mpa216/Deep-Learning-Accelerator-DLA-Engine-From-CNN-to-GenAI-SNN/3V3lib/gf180mcu_ocd_io-main/docs/index.rst

******************************************************
gf180mcu_ocd_io 5V pad / 3.3V core Inline non-CUP GPIO
******************************************************

.. centered::
   **Open Circuit Design 0.18µm **
.. centered::
   **5V pad / 3.3V core Wide-Range Inline non-CUP GPIO Library**
.. centered::
   **Datasheet**

.. toctree::
    :glob:

    datasheet
    features
    naming
    functional
    specs
