mpa216/Deep-Learning-Accelerator-DLA-Engine-From-CNN-to-GenAI-SNN/Papers/APIC_Paper/Revised_Reference/apsipa_version.tex

\documentclass[conference,a4paper]{APSIPA2026}
\usepackage{cite}
\usepackage{amsmath,amssymb,amsfonts}
\usepackage{graphicx}
\usepackage{textcomp}
\usepackage{xcolor}
\definecolor{figblue}{RGB}{37,84,160}
\definecolor{figred}{RGB}{198,58,45}
\usepackage{booktabs}
\usepackage{array}
\usepackage{multirow}
\usepackage{tikz}
\usetikzlibrary{shapes.geometric,arrows.meta,positioning,calc}
\usepackage{url}
\usepackage{geometry}
\geometry{a4paper, top=19mm, bottom=43mm, right=13mm, left=13mm}
\usepackage{fancyhdr}
\renewcommand{\headrulewidth}{0pt}
\renewcommand{\footrulewidth}{0pt}
\fancypagestyle{firststyle}{%
  \fancyhf{}%
  \fancyhead[C]{2026 Asia Pacific Signal and Information Processing Association Annual Summit and Conference (APSIPA ASC)}%
}
\usepackage[hidelinks]{hyperref}
\graphicspath{{figs/}}

\begin{document}

\title{An 8-bit Deep Learning Accelerator for\\GAN Image Generation on GF180MCU}

\author{
\IEEEauthorblockN{William Anthony, I~Made~Medika~Surya~W.M., John~Ruben~Saragi, Mahardhika~Putra~Adipratama,\\
Fairuz~Aquilla~Rahagi, Trio~Adiono, and Infall~Syafalni}
\IEEEauthorblockA{Bandung Institute of Technology, Bandung, Indonesia \\
E-mail: \{13223048, 13222021, 13222049, 13222081, 13222107\}@mahasiswa.itb.ac.id, \\
tadiono@itb.ac.id, infall@ieee.org}
}

\maketitle
\thispagestyle{firststyle}
\pagestyle{empty}

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

\begin{IEEEkeywords}
Deep learning accelerator, GF180MCU, SRAM macro, INT8 quantization, GAN, ASIC, LibreLane, open-source EDA.
\end{IEEEkeywords}

\section{Introduction}
Generative Adversarial Networks can be used as a compact workload for testing neural inference on custom hardware. In this work, the generator is a small MNIST multi-layer perceptron that converts a 64-dimensional latent vector into a $28\times28$ image. The arithmetic is mostly dense matrix multiplication, so the workload can be mapped onto a small array of multiply--accumulate units.

An earlier version of the design used sequential behavioral loops and register memory arrays in Verilog. That version was convenient for checking the algorithm, but not suitable for ASIC implementation: buffers inferred as standard-cell registers make the design too large and difficult to route. The design was therefore restructured into a structural accelerator with a processing-element (PE) array, local SRAM-backed buffers, and a small controller, and carried through a two-stage physical flow: the core is hardened as a macro, and the macro is integrated onto a padring for a shared-shuttle slot.

The main contributions are: (1)~an open INT8 GAN-generator accelerator on GF180MCU whose buffers use physical SRAM macros; (2)~a verification stack reaching from unit vectors to a bit-exact full-image render on the routed post-layout netlist; (3)~a single-supply 3.3~V implementation of the full flow, including third-party library fixes and a reproducible antenna-closure method; and (4)~chip-level integration behind a 4-wire serial interface with a clean sign-off.

\section{Related Work}
Most neural network accelerators are built around arrays of multiply-and-accumulate units. A well-known large-scale example is the systolic Tensor Processing Unit \cite{tpu}, and a broad overview of deep learning accelerators for different platforms is given in \cite{survey}. To run a floating-point network on this kind of integer array, the weights and activations are usually quantized with a per-tensor scale, as described by Jacob et al. \cite{jacob}.

The closest work to ours is Wang et al. \cite{wang}, which presents a small PE-array accelerator for an underwater recognition network in a 40~nm process. Our design is different because it targets the open GF180MCU 180~nm process and uses a full open-source flow from RTL to a tapeout-ready chip GDS. The workload is a pretrained MLP GAN \cite{goodfellow, ganpretrained}, and the RTL is based on the open DLA Engine project \cite{dlaengine}.

\section{GAN Architecture}\label{sec:overview}

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

The GAN generator architecture, illustrated in Fig.~\ref{fig:gan}, uses a multi-layer perceptron (MLP) model that receives a latent vector of size 64 as the initial input. This input is then projected through two hidden layers, each containing 256 neurons, to form a richer feature representation. Each hidden layer is followed by a ReLU activation function, allowing the model to learn non-linear patterns from the data.

After that, the learned representation is passed to an output layer with 784 neurons, which corresponds to a $28\times28$ pixel image. In the final stage, a tanh activation function is used to limit the output values to a range between $-1$ and $1$, so that the output of the generator can be represented as a grayscale image. Through this process, the generator transforms a random vector into a synthetic image that resembles real data.

Table~\ref{tab:net} lists the three dense layers and shows how many tiles each layer needs on the $4\times4$ array. Because the array produces four output neurons per tile, the layer with 784 outputs needs the most tiles.

\begin{table}[h]
\caption{Generator layers and their mapping to the $4\times4$ array.}
\label{tab:net}
\centering
\renewcommand{\arraystretch}{1.08}
\begin{tabular}{@{}lcccc@{}}
\toprule
Layer & Output $\times$ Input & Activation & Tiles & MAC ops \\
\midrule
L0 & $256\times64$  & ReLU & 64  & 16{,}384  \\
L2 & $256\times256$ & ReLU & 64  & 65{,}536  \\
L4 & $784\times256$ & Tanh & 196 & 200{,}704 \\
\midrule
Total & & & 324 & 282{,}624 \\
\bottomrule
\end{tabular}
\end{table}

\section{Hardware Architecture}\label{sec:hw}

The DLA computes a tiled matrix multiplication $C=A\times B$. The array size is $N=4$, and the native accumulation depth is $K=256$, so one transaction accumulates a full 256-term dot product---the inner dimension of the widest generator layers. $K$ is a temporal depth: it sets how many cycles the same 16 PEs accumulate, not the array size. An earlier RTL revision defaulted to $K=4$ and relied on a harness override; since the physical flow synthesizes the bare RTL defaults, the hardened default was widened to $K=256$---a parameter-only change, as the operand SRAMs were already 256 deep. During one transaction, the controller clears the PE accumulators, enables the array for $K$ cycles, and then stores the result block to the C buffer through a writeback path.

\begin{figure}[h]
\centering

\caption{DLA engine top level.}
\label{fig:top}
\end{figure}

At the top level, shown in Fig.~\ref{fig:top}, the A buffer provides one row vector to the PE array, and the B buffer provides one column vector. The control unit generates the read index, clear signal, enable signal, done signal, and busy signal. The output bus carries the accumulated C values.

\subsection{Processing Element}

Each processing element (Fig.~\ref{fig:pe}) receives two signed 8-bit inputs. It multiplies them, sign-extends the 16-bit product to 24 bits, and adds it to a local accumulator. The accumulator is cleared at the start of each matrix multiplication. The output of each PE is one dot product.

\begin{figure}[h]
\centering

\caption{Processing element datapath.}
\label{fig:pe}
\end{figure}

The main computation in one PE follows
\begin{equation}
acc_{out}[n] = acc_{out}[n-1] + a_{in}[n]\,b_{in}[n].
\end{equation}
After $K$ cycles, the accumulator stores one output value of the matrix multiplication tile. A 24-bit accumulator is used so that the sum of 8-bit products has enough range for the selected layer sizes.

\subsection{PE Array}
The PE array (Fig.~\ref{fig:pearray}) instantiates 16 PEs in a $4\times4$ grid. Each row receives one activation lane, and each column receives one weight lane; the operands are broadcast along the rows and columns, and each PE accumulates its result locally (an output-stationary organization), so all 16 PEs operate in parallel and the array produces one $4\times4$ output tile after the accumulation loop finishes.

The $a\_bus$ contains four 8-bit activation values, while the $b\_bus$ contains four 8-bit weight values. The output $c\_bus$ is flattened from 16 accumulator outputs, each with 24 bits.

\begin{figure}[h]
\centering

\caption{Processing element array.}
\label{fig:pearray}
\end{figure}

\subsection{Controller FSM}
The controller uses four states (Fig.~\ref{fig:fsm}). In IDLE, it waits for START. In CLEAR, it clears all PE accumulators for one cycle. In COMPUTE, it asserts the PE-array enable and increments the A and B buffer addresses until all $K$ terms have been processed. In DONE, it raises DONE and waits for START to return low before going back to IDLE. A separate writeback sequencer then serializes the 16 accumulator values into the C buffer and raises a writeback-done flag.

\begin{figure}[h]
\centering
\begin{tikzpicture}[
  font=\scriptsize,>={Stealth[length=2mm]},
  st/.style={draw,circle,minimum size=10mm,fill=green!8}
]
\node[st] (idle) {IDLE};
\node[st,right=11mm of idle] (clear) {CLEAR};
\node[st,right=11mm of clear] (comp) {COMP};
\node[st,right=15mm of comp] (done) {DONE};
\draw[->] (idle) -- node[above]{start} (clear);
\draw[->] (clear) -- (comp);
\path (comp) edge[->,loop above] node{$k<K-1$} (comp);
\draw[->] (comp) -- node[above]{$k=K-1$} (done);
\draw[->] (done) to[bend left=45] node[below]{!start} (idle);
\end{tikzpicture}
\caption{Controller state machine.}
\label{fig:fsm}
\end{figure}

\subsection{SRAM Buffers}
The input and output buffers are implemented with physical $256\times8$ single-port SRAM macros. The A buffer uses four macros, one for each row lane. The B buffer also uses four macros, one for each column lane. The C buffer stores 24-bit accumulator outputs by using three 8-bit SRAM macros as byte planes of one 24-bit word. In total, the design uses eleven SRAM macros, 2{,}816 bytes of storage; the roughly 280~KB of INT8 generator weights are streamed through these tiles from outside rather than stored on chip.

The SRAM wrapper has a behavioral memory model for simulation and a blackbox branch for synthesis; the power pins are not tied to logic constants in RTL but connected by the physical power delivery network during place and route. The SRAM read has one cycle of latency, so the top level delays the PE enable and completion flags by one cycle to keep data and control aligned, which prevents the PE array from accumulating invalid data after a read request.

\section{Chip-Level Integration}\label{sec:chip}

The hardened accelerator exposes 53 signal bits (a 10-bit write address alone, now that $K=256$), but the target shuttle slot provides only 20 general-purpose digital pads next to its 60 analog, 8 supply, clock, and reset pads. Instead of a pin-per-signal mapping, the chip core wraps the accelerator behind a small synchronous 4-wire serial bridge (SCLK, MOSI, CS\_N, MISO). The bridge treats SCLK as a data input: all three inputs are double-flop synchronized into the core clock domain and SCLK is edge-detected, which deliberately avoids a second clock domain. A frame is shifted MSB-first while CS\_N is low as a 2-bit command plus a 10-bit address (write frames append 8 data bits): WRITE\_A and WRITE\_B load the operand buffers, START launches one tile, and READ\_C returns one 24-bit two's-complement result on MISO. Raising CS\_N at any point aborts the frame safely. Three status flags (busy, done, writeback-done) bypass the serial link and drive pads directly, giving oscilloscope-visible liveness during board bring-up. In total the chip uses 9 of the slot's 91 pads (the serial link, the status flags, clock, and reset); the remaining bidir pads are tied off with pull-downs.

The padring is the wafer.space GF180MCU project template \cite{padring} for a $2935\times2935~\mu$m workshop slot. One consequence of the template is that the pad supply and the core supply are shorted into a single rail on every pad, so the chip is single-supply by construction. The adopted operating point is therefore 3.3~V for the whole die: the logic and SRAM are 3.3~V parts, and the foundry I/O cells are officially characterized for 3.3~V operation, so every cell on the die operates in a foundry-characterized corner and the I/O levels are directly compatible with a 3.3~V microcontroller host. Fig.~\ref{fig:chipgds} shows the final chip layout.

\begin{figure}[t]
\centering

\caption{Final chip layout ($2935\times2935~\mu$m slot): the DLA macro with its 11 SRAMs, the padring, and the template's identification blocks.}
\label{fig:chipgds}
\end{figure}

\section{Software to Hardware Flow}\label{sec:sw}

The system is separated into the hardware core and the verification environment. The hardware core is the DLA engine. It contains the A and B input buffers, the C output buffer, the controller, and the $4\times4$ PE array. This is the part that is hardened and taped out. The verification environment is written in Python and Verilog. It prepares quantized weights, input vectors, and reference outputs, then drives the accelerator through its normal read and write ports---or, at chip level, through the serial protocol exactly as an external host would. On the finished chip, the same role is played by a small microcontroller that streams the tile schedule over the serial link.

\begin{figure}[h]
\centering

\caption{Hardware and software flow.}
\label{fig:hwsoft}
\end{figure}

As shown in Fig.~\ref{fig:hwsoft}, Python prepares the input data and memory contents, then the RTL testbench loads the data into the hardware engine. After the engine finishes, the output is read back and passed to the activation-function stage. This split keeps the accelerator simple, while still allowing the complete GAN pipeline to be checked.

\subsection{Quantization and Requantization}
The original model weights are stored as 32-bit floating-point values. Before they can be used by the integer array, every weight and bias tensor is converted to signed 8-bit values using one scale factor per tensor. The scale comes from the largest absolute value in the tensor, and all scales are saved in a manifest file so the testbench can reuse the same values.

The DLA only returns the integer dot product of one tile. The rest of the math is done around it in integer form, so the hardware result matches the Python reference. For the two hidden layers, the integer result is rescaled, the bias is added, and a ReLU activation is applied before the value is quantized again to 8 bits for the next layer. For the output layer, the result is turned into a fixed-point value, passed through a tanh lookup table, and then mapped to a grayscale pixel. The lookup table is used so that tanh does not have to be computed directly in hardware.

\section{Verification}\label{sec:map}

To verify the GAN RTL result, the generator is mapped onto the DLA as a sequence of tiled dense layers. For each tile, four output neurons are computed at the same time: the four weight rows are written to the A buffer bank, and the shared input vector is written into the B buffer. The DLA then performs the dot products and stores the results in the C buffer. Layer L0 uses the 64-dimensional latent vector as input, and layers L2 and L4 use the 256-dimensional activations of the previous layer; since the array has four output lanes, L0 and L2 each require 64 tiles, while L4 requires 196 tiles. The same datapath is reused for all layers.

\begin{table}[h]
\caption{Verification results.}
\label{tab:verif}
\centering
\renewcommand{\arraystretch}{1.08}
\begin{tabular}{@{}lll@{}}
\toprule
Testbench & Check & Result \\
\midrule
\texttt{d3004\_tb} & one GEMM, single lane & PASS \\
\texttt{d3004n4\_tb} & full $N{=}4$/$K{=}256$ tile, all A/B macros & PASS \\
\texttt{g3005\_tb} & one layer row & PASS \\
\texttt{g300\_pipeline\_tb} & full 784-pixel image & PASS \\
\texttt{chip\_core\_dla\_tb} & pad-level serial protocol & PASS \\
gate-level (unit) & routed netlist, $N{=}4$/$K{=}256$ vectors & PASS \\
gate-level (image) & routed netlist, full 784-pixel image & PASS \\
\bottomrule
\end{tabular}
\end{table}

Table~\ref{tab:verif} summarizes the verification stack; all testbenches check against Python golden vectors. The two gate-level runs re-simulate the actual routed netlist produced by the physical flow (including its inserted buffers and roughly 7{,}700 antenna diodes) with the behavioral SRAM model and reproduce the golden results bit-exactly, closing the gap between ``the RTL is correct'' and ``the taped-out netlist is correct.'' The stack caught two real integration bugs before sign-off: the A and B buffers use different write-address layouts (row-major versus $k$-major), which one testbench initially got wrong, and the serial READ\_C path needed an extra wait state because a C-buffer address update is not visible to the registered SRAM read until the next cycle.

\begin{figure}[h]
\centering
\hspace{4mm}
\hspace{4mm}

\caption{Generated digit samples.}
\label{fig:samples}
\end{figure}

Fig.~\ref{fig:samples} shows examples of generated $28\times28$ images. The visual quality is limited by the small generator and by INT8 quantization, but the images are enough to verify that the full software-to-hardware path is running.

\section{Physical Implementation}\label{sec:phys}

The design is implemented with LibreLane \cite{librelane} on the GF180MCU open PDK \cite{gf180pdk} in two stages: the accelerator is hardened as a macro, and the macro GDS/LEF/liberty views are then consumed by the padring integration.

\subsection{Single-Supply 3.3~V Library Migration}
The buffer SRAM macro \cite{gf180sram} is a 3.3~V IP, but the open PDK ships only 5~V digital standard cells, so a first version of this design mixed a 5~V core with 3.3~V SRAMs---workable for layout checks but requiring level shifting on real silicon. The design was therefore migrated to the third-party \texttt{gf180mcu\_as\_sc\_mcu7t3v3} native-3.3~V standard-cell library, which ships nine liberty corners and a LibreLane integration, making the whole die single-supply. Bringing the library up surfaced three real bugs in its flow integration (a missing timing-corner variable, a synthesis-exclusion filename mismatch, and non-synthesizable \texttt{\$random} initializers in six sequential-cell models that crashed lint); all were fixed at the library source. The 3.3~V cells proved much faster than the 5~V ones: the initial run at the old 75~ns clock closed with $+44$~ns of setup slack, so the clock was retimed to 40~ns (25~MHz), and the SRAM liberty corners now match the standard cells one-to-one at every PVT point.

\subsection{Hardening the Accelerator Macro}
A few configuration points were essential. A synthesis define keeps the SRAM as a hard macro---without it, the memory is silently built from flip-flops. The eleven macros are registered with their LEF/GDS/liberty views and placed explicitly on a $4\times3$ grid with routing channels. The SRAM power pins only reach Metal3, so the macro power-grid connection had to be made on Metal3 instead of the default higher layers. Routing was allowed up to Metal5, standard-cell padding was added for diode pin access, and antenna diodes are inserted heuristically at placement time with the in-router antenna repair disabled.

The antenna check required an empirical closure method. Direct in-router antenna repair aborts unreliably in this flow because its verification reroute fails pin access on already-placed clock-net diodes, and the remaining violation was a wire-length problem on a long buffered net that already carried several diodes, so adding more diodes could not help. Larger floorplan changes (macro clustering, row swaps, fanout caps) consistently made the antenna count worse by creating new long routes. What worked---both for the earlier 5~V version and again here---is a small deterministic perturbation of the placement density on the same floorplan, which re-rolls which nets route long. Table~\ref{tab:antenna} shows the sweep for the final $K{=}256$ netlist: density 63 reaches zero antenna violations, and re-running that configuration reproduces a byte-identical placement-and-routing database, so the result is deterministic rather than a routing fluke.

\begin{table}[h]
\caption{Antenna closure sweep (placement density, $K{=}256$ netlist, 40~ns clock). All runs are DRC-, LVS-, and timing-clean.}
\label{tab:antenna}
\centering
\renewcommand{\arraystretch}{1.08}
\begin{tabular}{@{}lccl@{}}
\toprule
Density (\%) & Antenna nets & Setup slack (ns) & Result \\
\midrule
61 & 2 & $+15.53$ & \\
60 & 5 & $+15.75$ & worse \\
62 & 1 & $+15.60$ & \\
63 & 0 & $+15.12$ & clean sign-off \\
63 (re-run) & 0 & $+15.12$ & identical DEF \\
\bottomrule
\end{tabular}
\end{table}

\begin{figure}[t]
\centering

\caption{Hardened accelerator macro ($1600\times1500~\mu$m) with the eleven SRAM macros on a $4\times3$ grid.}
\label{fig:layout}
\end{figure}

Fig.~\ref{fig:layout} shows the resulting macro layout, and Table~\ref{tab:signoff} summarizes the sign-off results. Magic reports zero DRC errors, Netgen reports zero LVS errors, and the antenna report has zero violating nets and pins. The design meets the 40~ns clock at all nine STA corners: the worst setup slacks per corner family are $+23.41$~ns (TT), $+15.12$~ns (SS, 125\,\textdegree C, 3.0~V), and $+26.54$~ns (FF), and the worst hold slacks are $+0.260$, $+0.333$, and $+0.150$~ns respectively. The reported nominal power is 162~mW, almost entirely internal power estimated with the flow's default switching activity, and should be read as a conservative tool estimate rather than a measurement.

\begin{table}[h]
\caption{Hardened macro results.}
\label{tab:signoff}
\centering
\renewcommand{\arraystretch}{1.08}
\begin{tabular}{@{}ll@{}}
\toprule
Metric & Value \\
\midrule
Process & GF180MCU, 180 nm \\
Standard cells & \texttt{gf180mcu\_as\_sc\_mcu7t3v3} (3.3 V) \\
Die area & $1600\times1500~\mu$m \\
Core area & 2.326 mm$^2$ \\
Utilization & 48.6\% \\
SRAM macros & 11 \\
Standard-cell instances & 31,711 \\
Sequential cells & 406 \\
Clock period & 40 ns (25 MHz) \\
Worst setup slack (9 corners) & $+15.12$ ns \\
Worst hold slack (9 corners) & $+0.150$ ns \\
Magic DRC / Netgen LVS & 0 / 0 errors \\
Antenna & 0 nets, 0 pins \\
Power (nominal, tool estimate) & 162 mW \\
\bottomrule
\end{tabular}
\end{table}

\subsection{Full-Chip Implementation}
The padring integration re-runs the complete flow with the hardened macro as a black box. Two macro-interface issues had to be resolved: the macro's behavioral SRAM wrapper had to be black-boxed for the chip-level static timing reader, and four short power-strap fragments that the macro LEF exports as pins lie entirely under a Metal5 routing obstruction, which the chip-level power-grid builder rejects; they were reclassified as obstructions, which is electrically equivalent and strictly more conservative.

Chip-level timing needed particular care. The first sign-off run reported infinite slack at every corner---a hollow result: with no pad liberty views loaded, the timing tool treated every pad as an empty black box, the clock defined on the clock pad's output degraded to a virtual clock, and nothing was actually constrained. The fix was to load the foundry pad liberty at its 3.3~V characterization corners. The now-real numbers exposed one more constraint bug: the template's blanket input delays imposed hold checks on the three asynchronous serial inputs, which are synchronizer-guarded by design, and these were replaced by false-path constraints. After both fixes, all nine corners close with real paths (Table~\ref{tab:chip}).

\begin{table}[h]
\caption{Full-chip sign-off results.}
\label{tab:chip}
\centering
\renewcommand{\arraystretch}{1.08}
\begin{tabular}{@{}ll@{}}
\toprule
Metric & Value \\
\midrule
Slot die & $2935\times2935~\mu$m \\
Pads & 91 (9 used) \\
Instances / macros & 71,668 / 3 \\
Magic DRC / KLayout DRC & 0 / 0 \\
Chip-level LVS & 0 errors \\
Antenna & 0 nets, 0 pins \\
GDS XOR (Magic vs.\ KLayout) & 0 \\
Worst setup slack (9 corners) & $+21.67$ ns \\
Worst hold slack (9 corners) & $+0.329$ ns \\
Worst IR drop & 0.31 mV \\
\bottomrule
\end{tabular}
\end{table}

\subsection{Comparison}
Table~\ref{tab:compare} compares this work with a recent accelerator by Wang et al. \cite{wang}. Their design uses a smaller PE array on a 40~nm process and is not built with an open-source flow. Our design uses a larger array on the older 180~nm GF180MCU process and is built fully with open tools, and the whole result---from the quantization scripts to the final chip GDS---can be reproduced from the public flow. The larger area and higher power mostly come from the coarser process and the conservative clock, not from the architecture.

\begin{table}[h]
\caption{Comparison with a recent accelerator.}
\label{tab:compare}
\centering
\renewcommand{\arraystretch}{1.08}
\begin{tabular}{@{}lcc@{}}
\toprule
Parameter & Wang et al. (2024) & This work \\
\midrule
Technology       & TSMC 40 nm                 & GF180MCU 180 nm \\
Architecture     & $2\times2\times2$ PE array & $4\times4$ PE array, $K{=}256$ \\
Core area        & 11.97 mm$^2$               & 2.326 mm$^2$ \\
Total power      & 96.35 mW                   & 162 mW (estimate) \\
Open-source flow & No                         & Yes \\
\bottomrule
\end{tabular}
\end{table}

\section{Discussion}\label{sec:disc}
The array performs 16 MAC operations per cycle, a peak of 0.8~GOPS at 25~MHz. One image needs 324 tiles of 256 accumulation cycles each, about 3.6~ms of pure compute; effective utilization is lower because the broadcast schedule computes four unique neurons per tile and because each tile's operands must first be loaded into the buffers. On the finished chip, end-to-end latency is dominated by streaming the roughly 280~KB of weights through the serial link, which is a deliberate trade: the slot's pad budget and the 2.8~KB of on-chip SRAM favor a simple streaming tile engine over on-chip weight storage. Better weight reuse, double buffering, or a wider link would improve throughput.

The implementation also shows a trade-off between timing and antenna closure: floorplans that shortened the SRAM-to-MAC critical path consistently increased the antenna count, and the priority here was a clean physical sign-off rather than the fastest possible clock. The earlier voltage-domain concern was resolved structurally---the padring shorts the pad and core supplies, so the single-supply 3.3~V operating point removes the level-shifting problem entirely, at the cost of 3.3~V (rather than 5~V) I/O levels, which matches the intended microcontroller host anyway. A true dual-rail variant was evaluated and deferred because the only available dual-voltage pad library is not yet silicon-ready. A bring-up plan for the returned silicon is prepared: current-limited power-on, status-pin checks, replay of the unit-test golden vectors over the serial link from a bit-banging 3.3~V microcontroller, and finally a full streamed digit render.

\section{Conclusion}\label{sec:concl}
This work implements a small INT8 GAN-generator accelerator on GF180MCU and carries it to a tapeout-ready chip with a fully open-source flow. The design replaces behavioral memory arrays with eleven SRAM macros, uses a $4\times4$ PE array with a native $K{=}256$ accumulation depth for tiled matrix multiplication, and verifies the output against Python references at every level up to a bit-exact full-image render on the routed post-layout netlist. Both the hardened macro and the integrated chip pass DRC, LVS, and antenna checks cleanly and close timing at 40~ns across nine corners on a single 3.3~V supply. The main remaining work is silicon bring-up and improving data reuse for higher throughput.

\section*{Acknowledgment}
The authors thank the open-source EDA community, the GlobalFoundries open PDK program for GF180MCU and the SRAM macro, and the wafer.space chipathon program for the padring template and the shuttle slot targeted by this work.

\begin{thebibliography}{12}
\bibitem{tpu} N. P. Jouppi \emph{et al.}, ``In-datacenter performance analysis of a tensor processing unit,'' in \emph{Proc. ISCA}, 2017.
\bibitem{survey} C. Silvano \emph{et al.}, ``A survey on deep learning hardware accelerators for heterogeneous HPC platforms,'' \emph{ACM Computing Surveys}, 2025.
\bibitem{jacob} B. Jacob, S. Kligys, B. Chen, M. Zhu, M. Tang, A. Howard, H. Adam, and D. Kalenichenko, ``Quantization and training of neural networks for efficient integer-arithmetic-only inference,'' in \emph{Proc. IEEE/CVF CVPR}, 2018.
\bibitem{wang} C. C. Wang, S. H. Luo, H. C. Wu, R. G. B. Sangalang, C. P. Jou, and H. Hsia, ``A 54.61 GOPS 96.35 mW digital logic accelerator for underwater object recognition DNN using 40 nm CMOS process,'' in \emph{Proc. IEEE 6th Int. Conf. AI Circuits and Systems (AICAS)}, 2024.
\bibitem{goodfellow} I. Goodfellow, J. Pouget-Abadie, M. Mirza, B. Xu, D. Warde-Farley, S. Ozair, A. Courville, and Y. Bengio, ``Generative adversarial nets,'' in \emph{Proc. NeurIPS}, 2014.
\bibitem{ganpretrained} C. Singh, ``GAN/VAE pretrained PyTorch models,'' \url{https://github.com/csinva/gan-vae-pretrained-pytorch}.
\bibitem{dlaengine} ``DLA Engine,'' GitHub, \url{https://github.com/wlmoi/DLA_Engine}.
\bibitem{padring} wafer.space, ``GF180MCU project template,'' \url{https://github.com/wafer-space/gf180mcu-project-template}.
\bibitem{librelane} The LibreLane project, ``LibreLane: an open-source RTL-to-GDSII flow,'' \url{https://github.com/librelane/librelane}.
\bibitem{gf180pdk} GlobalFoundries and Google, ``GF180MCU open-source PDK,'' \url{https://github.com/google/gf180mcu-pdk}.
\bibitem{gf180sram} R. T. Edwards, ``GF180MCU OCD IP SRAM macros,'' \url{https://github.com/RTimothyEdwards/gf180mcu_ocd_ip_sram}.
\end{thebibliography}

\end{document}
