mpa216/Deep-Learning-Accelerator-DLA-Engine-From-CNN-to-GenAI-SNN/Papers/APIC_Paper/apic_a_apsipa2026.pdf

2026 Asia Pacific Signal and Information Processing Association Annual Summit and Conference (APSIPA ASC)

# An 8-bit Deep Learning Accelerator for GAN Image Generation on GF180MCU

William Anthony, I Made Medika Surya W.M., John Ruben Saragi, Mahardhika Putra Adipratama, Fairuz Aquilla Rahagi, Trio Adiono, and Infall Syafalni Bandung Institute of Technology, Bandung, Indonesia E-mail: {13223048, 13222021, 13222049, 13222081, 13222107}@mahasiswa.itb.ac.id, tadiono@itb.ac.id, infall@ieee.org

Abstract—This paper presents an 8-bit deep learning accelerator for a small GAN image generator, taken through a fully open-source flow to a tapeout-ready chip on the open GF180MCU 180 nm process. The target network is a three-layer multi-layerperceptron generator trained on MNIST, quantized from FP32 to signed 8-bit integers and mapped onto a structural 4 × 4 processing-element array with a native accumulation depth of K = 256. The A, B, and C operand buffers use eleven physical 256 × 8 SRAM macros instead of inferred register arrays. The accelerator is hardened with LibreLane as a single-supply 3.3 V macro with zero DRC, LVS, and antenna violations at a 40 ns clock across nine STA corners, and is then integrated behind a 4-wire serial interface onto a 2935 × 2935 µm padring, which again signs off clean at chip level, including chip-level LVS over 71,668 instances. Functional correctness is verified against Python golden vectors at every level, from a single matrix multiplication up to a full 784-pixel image rendered bit-exactly through the routed post-layout netlist.
Index Terms—Deep learning accelerator, GF180MCU, SRAM macro, INT8 quantization, GAN, ASIC, LibreLane, open-source EDA.
I. INTRODUCTION

Generative Adversarial Networks can be used as a compact workload for testing neural inference on custom hardware. In this work, the generator is a small MNIST multi-layer perceptron that converts a 64-dimensional latent vector into a 28 × 28 image. The arithmetic is mostly dense matrix multiplication, so the workload can be mapped onto a small array of multiply–accumulate units.
An earlier version of the design used sequential behavioral loops and register memory arrays in Verilog. That version was convenient for checking the algorithm, but not suitable for ASIC implementation: buffers inferred as standard-cell registers make the design too large and difficult to route. The design was therefore restructured into a structural accelerator with a processing-element (PE) array, local SRAM-backed buffers, and a small controller, and carried through a two-stage physical flow: the core is hardened as a macro, and the macro is integrated onto a padring for a shared-shuttle slot.
The main contributions are: (1) an open INT8 GAN-generator accelerator on GF180MCU whose buffers use physical SRAM macros; (2) a verification stack reaching from unit vectors to a bit-exact full-image render on the routed post-layout netlist; (3) a single-supply 3.3 V implementation of the full flow, including third-party library fixes and a reproducible antenna-closure method; and (4) chip-level integration behind a 4-wire serial interface with a clean sign-off.

II. RELATED WORK

Most neural network accelerators are built around arrays of multiply-and-accumulate units. A well-known large-scale example is the systolic Tensor Processing Unit [1], and a broad overview of deep learning accelerators for different platforms is given in [2]. To run a floating-point network on this kind of integer array, the weights and activations are usually quantized with a per-tensor scale, as described by Jacob et al. [6]. Among fabricated accelerators, the reference points span three orders of magnitude in scale. DianNao [3] places 496 16-bit fixed-point operators in 3.02 mm² of 65 nm and reaches 452 GOPS at 485 mW. Eyeriss [4] spends a 12.25 mm² 65 nm core on 168 processing elements with a row-stationary dataflow that minimizes data movement, and measures 278 mW at 200 MHz. Closer to our own scale, Wang et al. [7] present a small reconfigurable PE-array accelerator for an underwater recognition network in 40 nm, at 54.61 GOPS and 96.35 mW. All three are closed-PDK designs on commercial nodes.
The comparison that matters most for the contribution claimed here is against silicon built the same way. OpenSpike
[5] is a spiking-neural-network accelerator taped out in the open SkyWater 130 nm process using only open-source EDA tools and OpenRAM-generated memory macros, occupying 33.3 mm²
at 40 MHz. Our design shares that open-flow premise but differs in workload and memory strategy: it is an INT8 dense-matrix engine backed by foundry-supplied hard SRAM macros rather than a spiking architecture with generated memory, and it is carried through padring integration to a complete chip. Section IX places all of these side by side. The workload is a pretrained MLP GAN [8], [9], and the RTL is based on the open DLA Engine project [10].

III. GAN ARCHITECTURE

The GAN generator architecture, illustrated in Fig. 1, uses a multi-layer perceptron (MLP) model that receives a latent vector of size 64 as the initial input. This input is then projected through two hidden layers, each containing 256 neurons, to

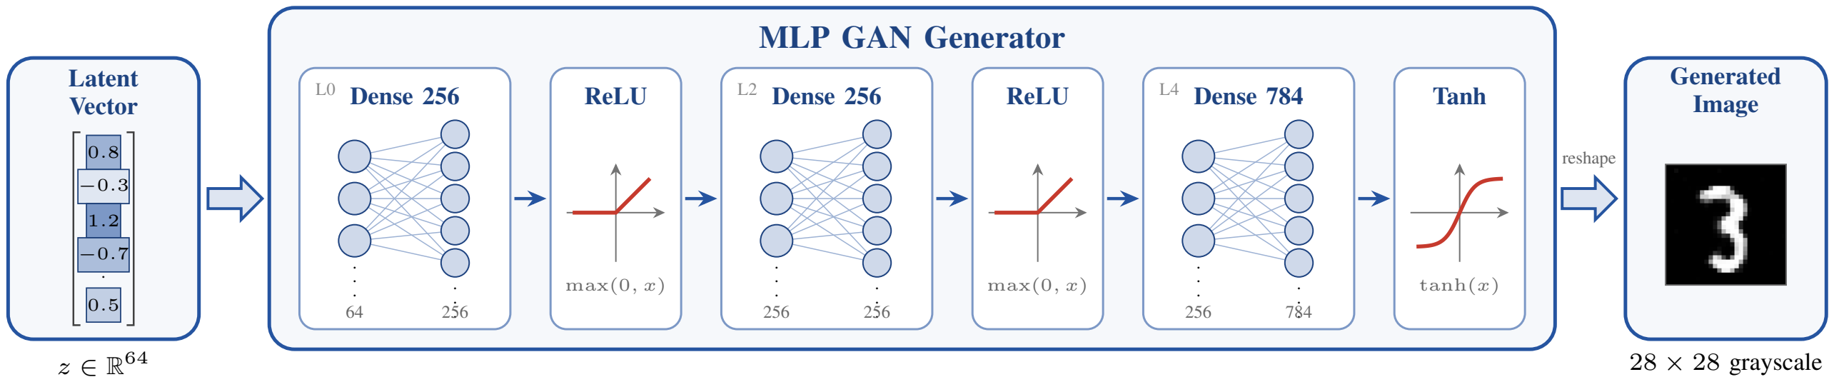
[picture p37: figure]
MLP GAN Generator; reshape; Latent Vector; Dense 256 L0; Dense 256 L2; Dense 784 L4; ReLU; Tanh; max(0, x); tanh(x); Generated Image; 28 × 28 grayscale

Fig. 1. MLP GAN generator: the 64-dimensional latent vector z is expanded through two 256-neuron ReLU hidden layers and a 784-neuron tanh output layer into a 28 × 28 grayscale image (layer tags match Table I).

form a richer feature representation. Each hidden layer is
followed by a ReLU activation function, allowing the model to learn non-linear patterns from the data.
After that, the learned representation is passed to an output layer with 784 neurons, which corresponds to a 28 × 28 pixel image. In the final stage, a tanh activation function is used to limit the output values to a range between −1 and 1, so that the output of the generator can be represented as a grayscale image. Through this process, the generator transforms a random vector into a synthetic image that resembles real data.
Table I lists the three dense layers and shows how many tiles each layer needs on the 4×4 array. Because the array produces four output neurons per tile, the layer with 784 outputs needs the most tiles.

TABLE I
GENERATOR LAYERS AND THEIR MAPPING TO THE 4 × 4 ARRAY.
Layer | Output × Input | Activation | Tiles | MAC ops
L0 | 256 × 64 | ReLU | 64 | 16,384
L2 | 256 × 256 | ReLU | 64 | 65,536
L4 | 784 × 256 | Tanh | 196 | 200,704
Total | | | 324 | 282,624

IV. HARDWARE ARCHITECTURE

The DLA computes a tiled matrix multiplication C = A×B. The array size is N = 4, and the native accumulation depth is K = 256, so one transaction accumulates a full 256-term dot product—the inner dimension of the widest generator layers. K is a temporal depth: it sets how many cycles the same 16 PEs accumulate, not the array size. An earlier RTL revision defaulted to K = 4 and relied on a harness override; since the physical flow synthesizes the bare RTL defaults, the hardened default was widened to K = 256—a parameter-only change, as the operand SRAMs were already 256 deep. During one transaction, the controller clears the PE accumulators, enables the array for K cycles, and then stores the result block to the C buffer through a writeback path.
At the top level, shown in Fig. 2, the A buffer provides one row vector to the PE array, and the B buffer provides one column vector. The control unit generates the read index, clear

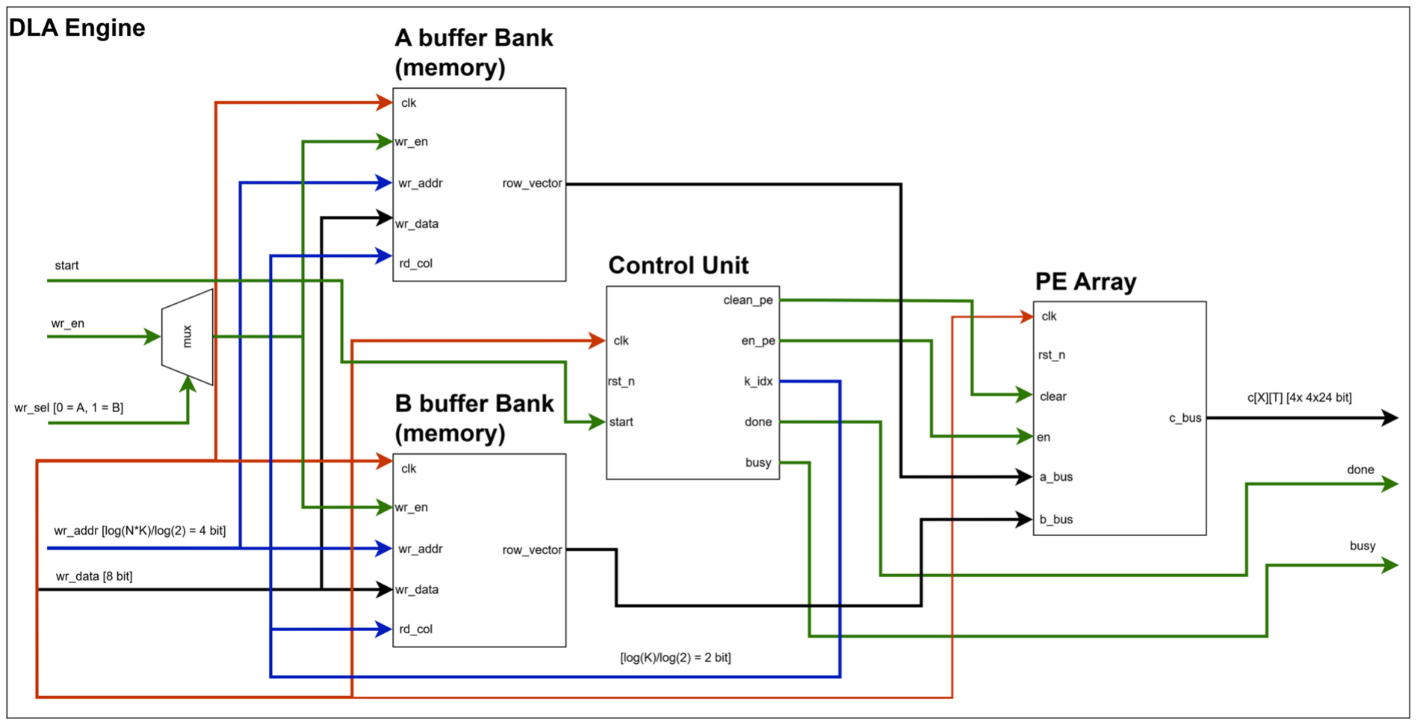
[picture p38: figure]

Fig. 2. DLA engine top level.

signal, enable signal, done signal, and busy signal. The output bus carries the accumulated C values.

A. Processing Element
Each processing element (Fig. 3) receives two signed 8-bit inputs. It multiplies them, sign-extends the 16-bit product to 24 bits, and adds it to a local accumulator. The accumulator is cleared at the start of each matrix multiplication. The output of each PE is one dot product.


Fig. 3. Processing element datapath.

The main computation in one PE follows

accout[n] = accout[n − 1] + ain[n] bin[n]. | (1)

After K cycles, the accumulator stores one output value of the matrix multiplication tile. A 24-bit accumulator is used so that the sum of 8-bit products has enough range for the selected layer sizes.

B. PE Array
The PE array (Fig. 4) instantiates 16 PEs in a 4×4 grid. Each row receives one activation lane, and each column receives one weight lane; the operands are broadcast along the rows and columns, and each PE accumulates its result locally (an outputstationary organization), so all 16 PEs operate in parallel and the array produces one 4×4 output tile after the accumulation loop finishes.
The a bus contains four 8-bit activation values, while the b bus contains four 8-bit weight values. The output c bus is flattened from 16 accumulator outputs, each with 24 bits.


Fig. 4. Processing element array.

C. Controller FSM
The controller uses four states (Fig. 5). In IDLE, it waits for START. In CLEAR, it clears all PE accumulators for one cycle. In COMPUTE, it asserts the PE-array enable and increments the A and B buffer addresses until all K terms have been processed. In DONE, it raises DONE and waits for START to return low before going back to IDLE. A separate writeback sequencer then serializes the 16 accumulator values into the C buffer and raises a writeback-done flag.

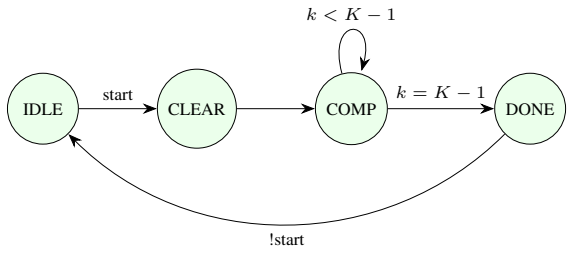
[picture p39: figure]
IDLE; CLEAR; COMP; DONE; start; !start

Fig. 5. Controller state machine.

D. SRAM Buffers
The input and output buffers are implemented with physical 256 × 8 single-port SRAM macros. The A buffer uses four macros, one for each row lane. The B buffer also uses four macros, one for each column lane. The C buffer stores 24-bit accumulator outputs by using three 8-bit SRAM macros as byte planes of one 24-bit word. In total, the design uses eleven SRAM macros, 2,816 bytes of storage; the roughly 280 KB of INT8 generator weights are streamed through these tiles from outside rather than stored on chip.
The SRAM wrapper has a behavioral memory model for simulation and a blackbox branch for synthesis; the power pins are not tied to logic constants in RTL but connected by the physical power delivery network during place and route. The SRAM read has one cycle of latency, so the top level delays the PE enable and completion flags by one cycle to keep data and control aligned, which prevents the PE array from accumulating invalid data after a read request.
V. CHIP-LEVEL INTEGRATION


Fig. 6. Final chip layout (2935 × 2935 µm slot): the DLA macro with its 11 SRAMs, the padring, and the template’s identification blocks.

The hardened accelerator exposes 53 signal bits, but the target shuttle slot provides only 20 general-purpose digital pads next to its 60 analog, 8 supply, clock, and reset pads. Instead of a pin-per-signal mapping, the chip core wraps the accelerator behind a synchronous 4-wire serial bridge (SCLK, MOSI, CS N, MISO). The bridge treats SCLK as a data input: all three inputs are double-flop synchronized into the core clock domain and SCLK is edge-detected, deliberately avoiding a second clock domain. A frame is shifted MSBfirst while CS N is low as a 2-bit command plus a 10-bit address, write frames appending 8 data bits: WRITE A and WRITE B load the operand buffers, START launches one tile, and READ C returns one 24-bit two’s-complement result on MISO. Raising CS N aborts the frame safely. Three status flags (busy, done, writeback-done) bypass the link and drive pads directly for oscilloscope-visible liveness at bring-up. The chip uses 9 of the slot’s 91 pads; the remaining bidir pads are tied off.
The padring is the wafer.space GF180MCU project template
[11] for a 2935 × 2935 µm workshop slot. One consequence of the template is that the pad supply and the core supply are shorted into a single rail on every pad, so the chip is single-supply by construction. The adopted operating point is therefore 3.3 V for the whole die: the logic and SRAM are 3.3 V parts, and the foundry I/O cells are officially characterized for 3.3 V operation, so every cell on the die operates in a foundry-characterized corner and the I/O levels are directly compatible with a 3.3 V microcontroller host. Fig. 6 shows the final chip layout.

VI. SOFTWARE TO HARDWARE FLOW
The system is separated into the hardware core and the verification environment. The hardware core is the DLA engine. It contains the A and B input buffers, the C output buffer, the controller, and the 4 × 4 PE array. This is the part that is hardened and taped out. The verification environment is written in Python and Verilog. It prepares quantized weights, input vectors, and reference outputs, then drives the accelerator through its normal read and write ports—or, at chip level, through the serial protocol exactly as an external host would. On the finished chip, the same role is played by a small microcontroller that streams the tile schedule over the serial link.


Fig. 7. Hardware and software flow.

As shown in Fig. 7, Python prepares the input data and memory contents, then the RTL testbench loads the data into the hardware engine. After the engine finishes, the output is read back and passed to the activation-function stage. This split keeps the accelerator simple, while still allowing the complete GAN pipeline to be checked.

A. Quantization and Requantization
The original model weights are stored as 32-bit floating-point values. Before they can be used by the integer array, every weight and bias tensor is converted to signed 8-bit values using one scale factor per tensor. The scale comes from the largest absolute value in the tensor, and all scales are saved in a manifest file so the testbench can reuse the same values. The DLA only returns the integer dot product of one tile. The rest of the math is done around it in integer form, so the hardware result matches the Python reference. For the two hidden layers, the integer result is rescaled, the bias is added, and a ReLU activation is applied before the value is quantized again to 8 bits for the next layer. For the output layer, the result is turned into a fixed-point value, passed through a tanh lookup table, and then mapped to a grayscale pixel. The lookup table is used so that tanh does not have to be computed directly in hardware.
B. Why INT8
The operand width sets multiplier area, buffer depth, and weight-stream volume at once, so it was chosen by measurement. Each candidate format was applied to the same FP32 checkpoint under this project’s quantization scheme and the

TABLE II
NUMERIC FORMATS FOR THIS GENERATOR: ACCURACY AGAINST AN EXACT FP64 RENDER (10 LATENTS, 7,840 PIXELS), AND HARDWARE COST. PE AREA IS SYNTHESIZED ON THE 3.3 V CELLS; ACCUMULATOR WIDTH IS WHAT 256 ACCUMULATED PRODUCTS NEED.
Pixel error (gray levels) | Weights | PE area | Acc.
Format | mean | max | (KiB) | (µm²
| | | | ) | (bits)
INT4 | 22.26 | 255 | 138 | 6,245 | 15
INT8 | 1.22 | 72 | 276 | 15,963 | 23
INT16 | 0.01 | 1 | 552 | 47,037 | 39
FP16 | 0.06 | 5 | 552 | — | —

rendered image compared against an exact FP64 render of the same latent, with error in gray levels of 255; the hardware side is the synthesized area of one PE at each width, the accumulator sized to what K = 256 requires (Table II). INT4 is not viable here: a per-tensor scale leaves only seven magnitude steps, and accumulating that coarseness over 256 terms destroys the digit rather than degrading it. INT16 is essentially exact but costs 2.95× the PE area, a 39-bit accumulator, and double the weight traffic — which, since weight streaming dominates end-to-end latency (Section IX), would double the time per image. FP16 is no more accurate than INT16 while needing the same memory and a different datapath (exponent alignment, normalization, rounding); no PE area is quoted because none was built. INT8 sits at the knee: 1.2 gray levels of average error is invisible in a 28 × 28 digit, the 16-bit product fits the 24-bit accumulator, and the operand width matches the SRAM macro’s native word, so the buffers need no packing logic.

VII. VERIFICATION

Fig. 8. Generated digit samples.

TABLE III
VERIFICATION RESULTS.
Testbench | Check | Result
d3004_tb | one GEMM, single lane | PASS
d3004n4_tb | full N=4/K=256 tile, all A/B macros | PASS
g3005_tb | one layer row | PASS
g300_pipeline_tb | full 784-pixel image | PASS
chip_core_dla_tb | pad-level serial protocol | PASS
gate-level (unit) | routed netlist, N=4/K=256 vectors | PASS
gate-level (image) | routed netlist, full 784-pixel image | PASS
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
