mpa216/Deep-Learning-Accelerator-DLA-Engine-From-CNN-to-GenAI-SNN/Papers/APIC_Paper/apic_a_revised_ieee_draft.pdf

# 8 Bit Deep Learning Accelerator for GAN Image Generation on GF180MCU

William Anthony
Bandung Institute of Technology 13223048
Bandung, Indonesia
13223048@mahasiswa.itb.ac.id

I Made Medika Surya W.M.
Bandung Institute of Technology 13222021
Bandung, Indonesia
13222021@mahasiswa.itb.ac.id

John Ruben Saragi
Bandung Institute of Technology 13222049
Bandung, Indonesia
13222049@mahasiswa.itb.ac.id
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
