mpa216/Deep-Learning-Accelerator-DLA-Engine-From-CNN-to-GenAI-SNN/layout_announcement/Layout_presentation/Chipathon - Week 37 - 11 September 2026.pptx - Google Slides_files/Screenshot from 2026-09-26 16-04-45.png

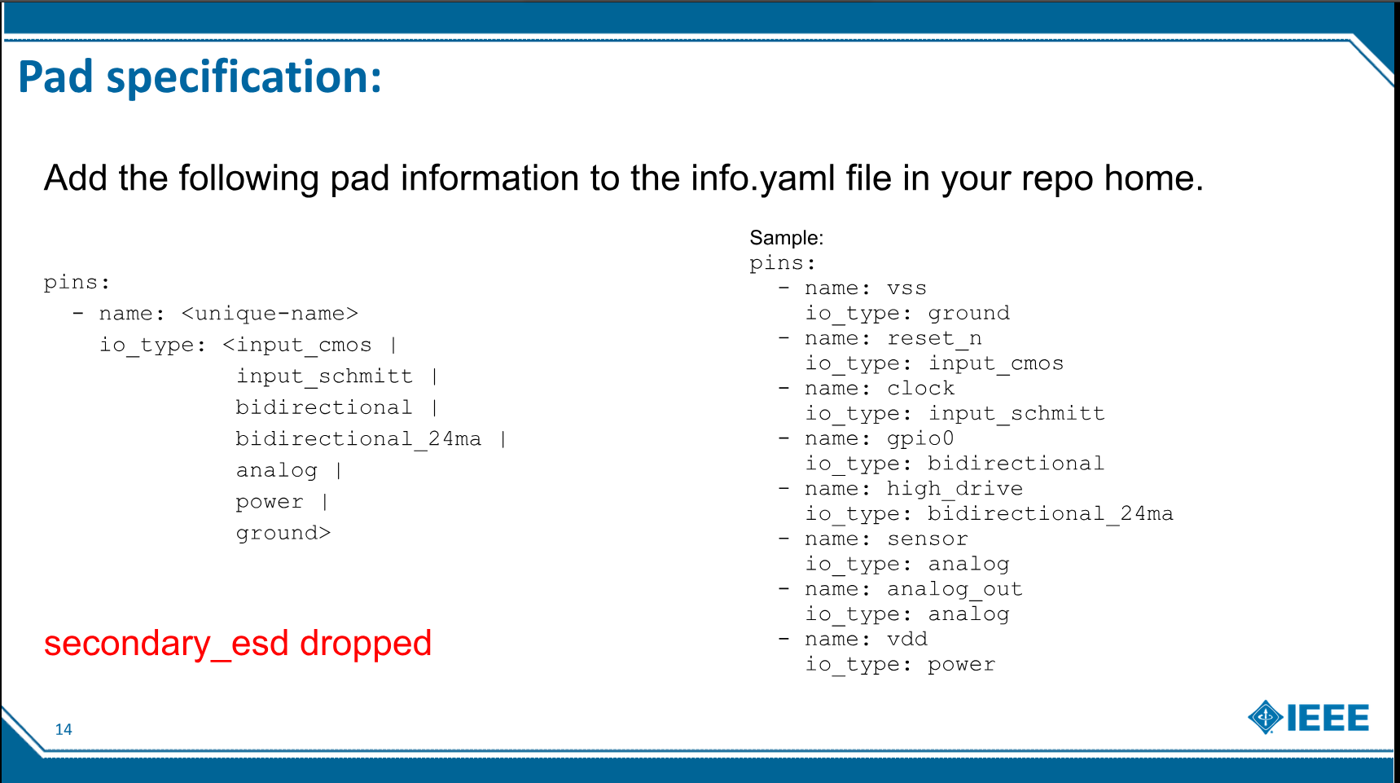
layout_announcement/Layout_presentation/Chipathon - Week 37 - 11 September 2026.pptx - Google Slides_files/Screenshot from 2026-09-26 16-04-45.png
