mpa216/Deep-Learning-Accelerator-DLA-Engine-From-CNN-to-GenAI-SNN/librelane/acv_render2/chip_full.png

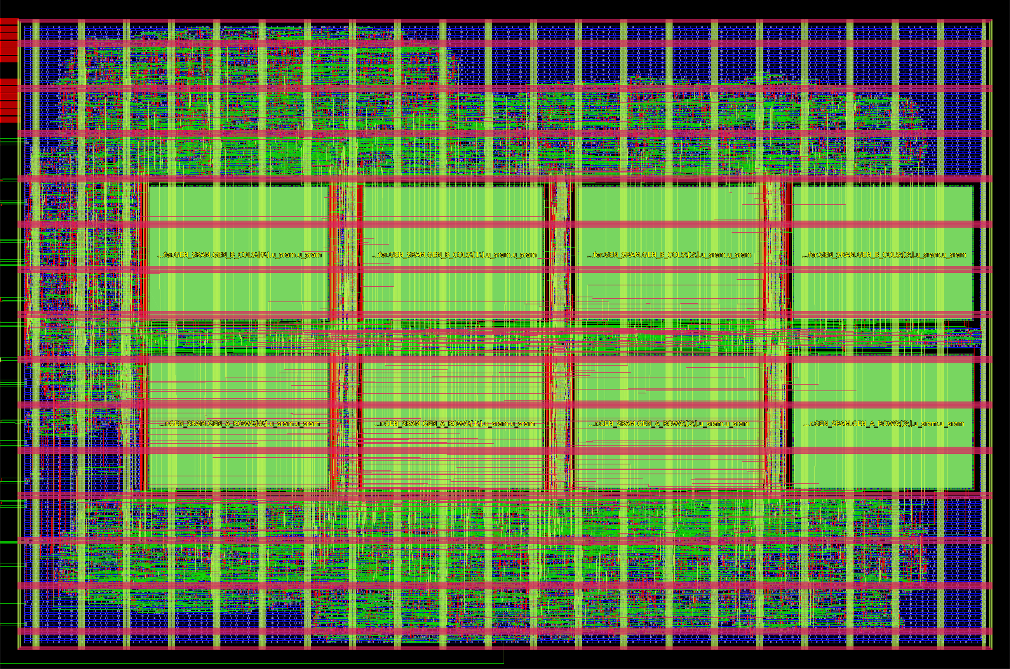
librelane/acv_render2/chip_full.png
