mpa216/Deep-Learning-Accelerator-DLA-Engine-From-CNN-to-GenAI-SNN/Papers/APIC_Paper_GAN/figs/gan_padring_gds.png

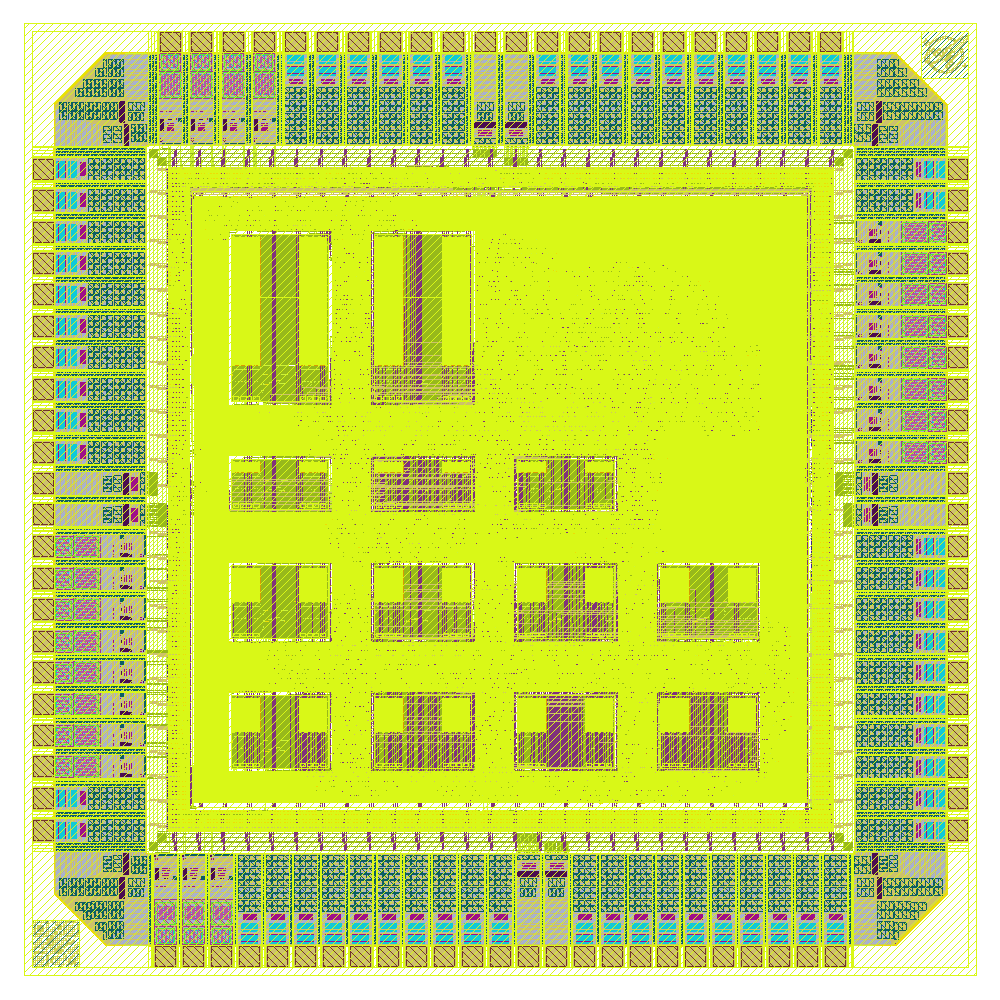
Papers/APIC_Paper_GAN/figs/gan_padring_gds.png
