mpa216/Deep-Learning-Accelerator-DLA-Engine-From-CNN-to-GenAI-SNN/signoff/A56/die_overview.png

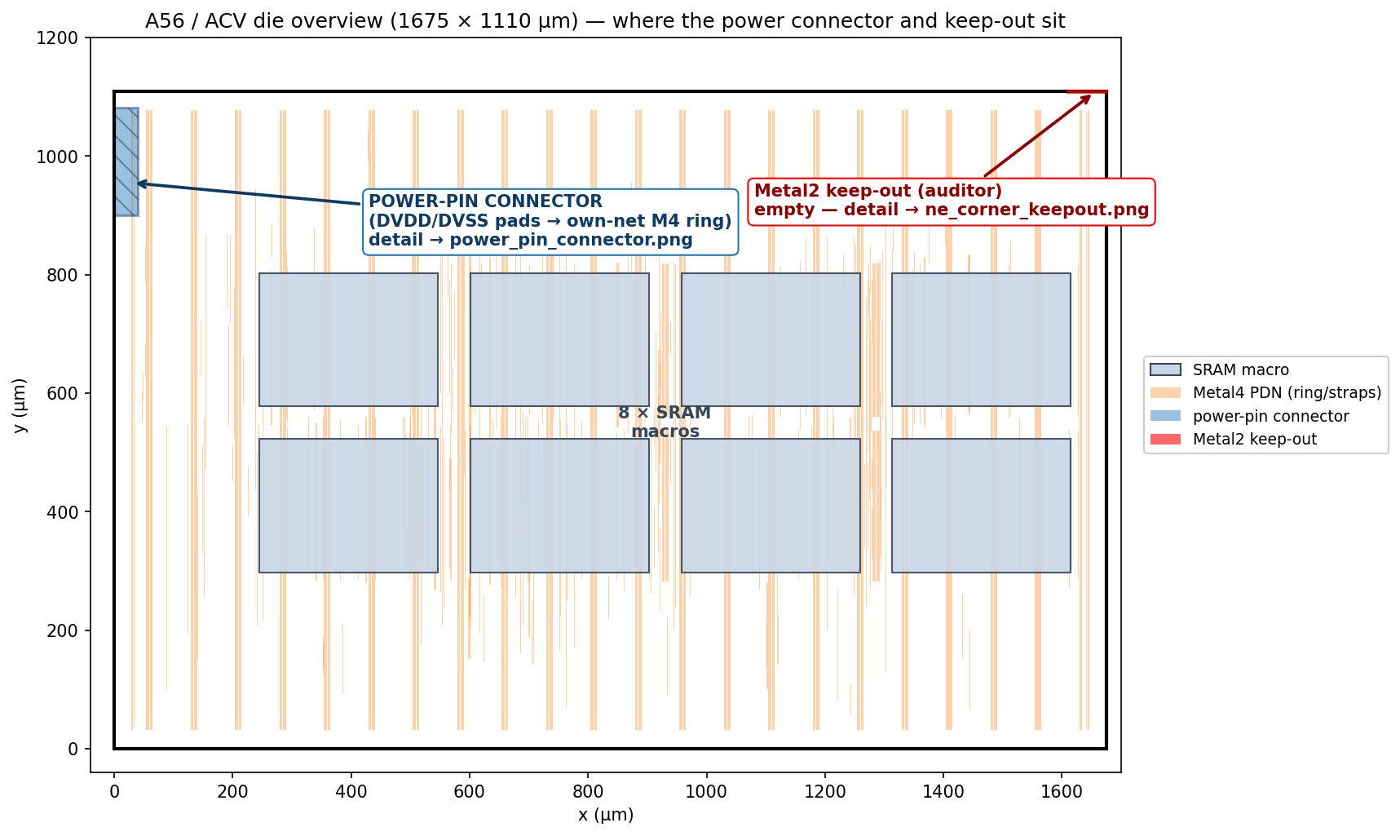
signoff/A56/die_overview.png
