mpa216/Deep-Learning-Accelerator-DLA-Engine-From-CNN-to-GenAI-SNN/signoff/A56/ne_corner_keepout.png

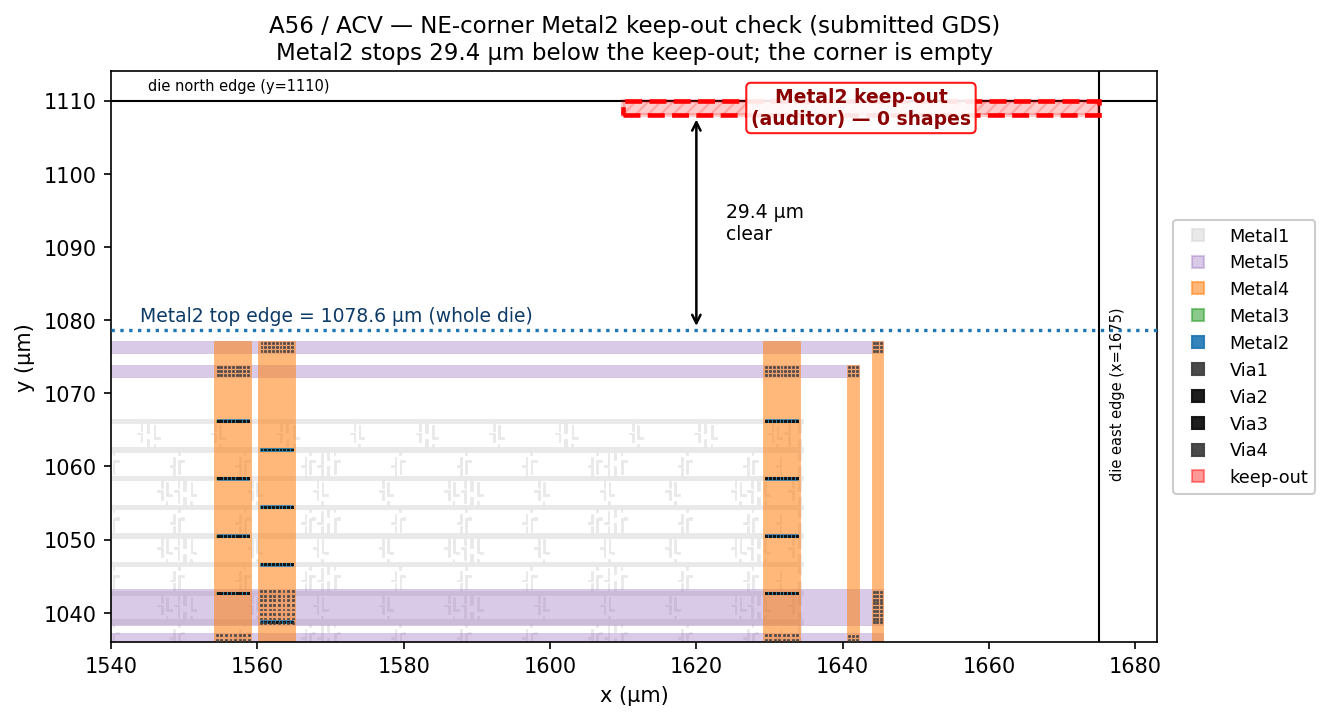
signoff/A56/ne_corner_keepout.png
