mpa216/Deep-Learning-Accelerator-DLA-Engine-From-CNN-to-GenAI-SNN/signoff/A56/power_pin_connector.png

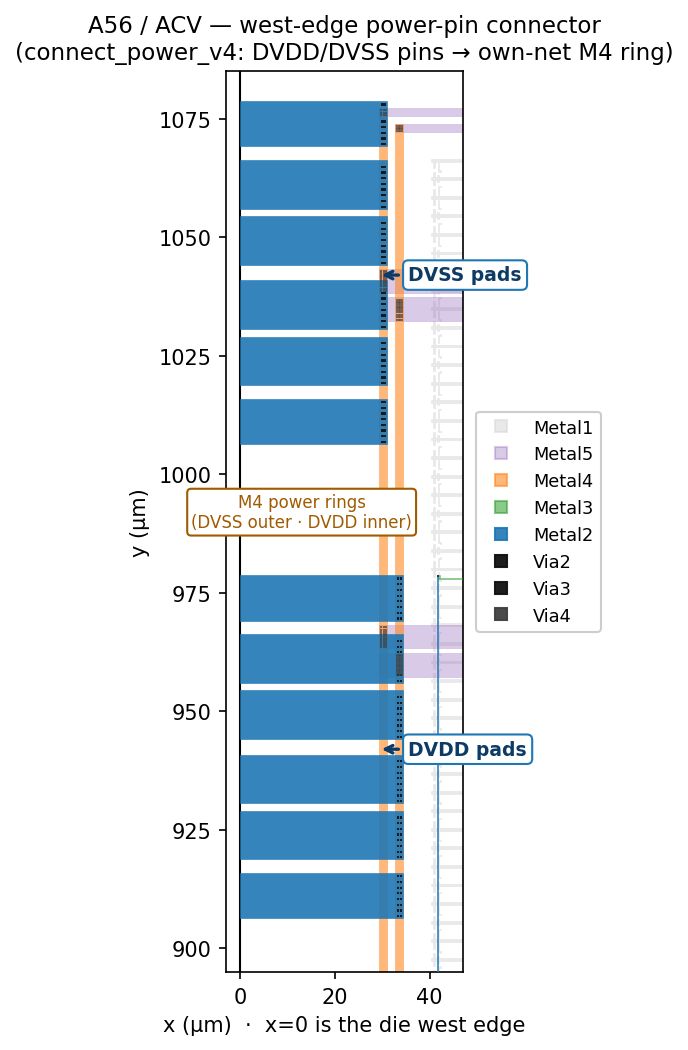
signoff/A56/power_pin_connector.png
