mpa216/Deep-Learning-Accelerator-DLA-Engine-From-CNN-to-GenAI-SNN/tb/data/d3004_input_16x16.jpg

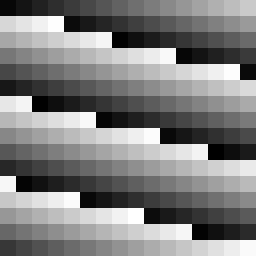
tb/data/d3004_input_16x16.jpg
