mpa216/Deep-Learning-Accelerator-DLA-Engine-From-CNN-to-GenAI-SNN/tb/data/g300_digit_seed4_expected.png

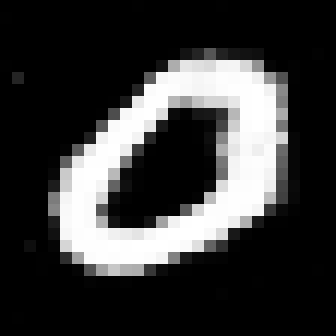
tb/data/g300_digit_seed4_expected.png
