mpa216/Deep-Learning-Accelerator-DLA-Engine-From-CNN-to-GenAI-SNN/tb/data/g300_output0_28x28.jpg

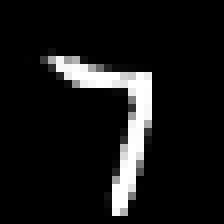
tb/data/g300_output0_28x28.jpg
