mpa216/Deep-Learning-Accelerator-DLA-Engine-From-CNN-to-GenAI-SNN/tb/data/g300_samples/g300_output1_28x28.jpg

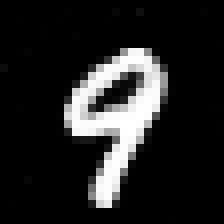
tb/data/g300_samples/g300_output1_28x28.jpg
