mpa216/Deep-Learning-Accelerator-DLA-Engine-From-CNN-to-GenAI-SNN/layout_announcement/Chipation 2026 project gds audit.xlsx

Sheet: Projects
Team | Top_cell | gds_file | width | height | Size Check | Export | Status | Slot Type | Pin Count | power | ground | analog-ESD | analog+ESD | input_cmos | input_schmitt | bidirectional | bidirectional_24ma | unmatched | errors
A01 | chip_top | chip_top.gds | 1110 | 550 | TRUE | OK |  | BH | 12 | 2:VDDA VDDD | 2:VSSA VSSD | 7:IBIAS ISS VTUNE CP_OUT Q_N I_N Q_P | 0: | 1:REF_IN | 0: | 0: | 0: | 1:I_P
A02 | A02_A | A02_A.gds | 1110 | 1110 | TRUE | OK |  | X | 146 | 1:VDD | 1:VSS | 0: | 0: | 19:clk data_IN[7] data_IN[5] data_IN[6] data_IN[4] data_IN[0] data_IN[1] data_IN[2] data_IN[3] addr[0] addr[1] addr[2] addr[3] irq_IN re debug_state_IN[0] debug_state_IN[2] debug_state_IN[1] we | 1:rst_n | 124:clk_PU clk_PD data_CS[7] data_SL[7] data_IE[7] data_OE[7] data_PU[7] data_PD[7] data_OUT[7] data_PDRV0[7] data_PDRV1[7] data_CS[5] data_SL[5] data_IE[5] data_OE[5] data_PU[5] data_PD[5] data_OUT[5] data_PDRV0[5] data_PDRV1[5] data_CS[6] data_SL[6] data_IE[6] data_OE[6] data_PU[6] data_PD[6] data_OUT[6] data_PDRV0[6] data_PDRV1[6] data_CS[4] data_SL[4] data_IE[4] data_OE[4] data_PU[4] data_PD[4] data_OUT[4] data_PDRV0[4] data_PDRV1[4] data_CS[0] data_SL[0] data_IE[0] data_OE[0] data_PU[0] data_PD[0] data_OUT[0] data_PDRV0[0] data_PDRV1[0] data_CS[1] data_SL[1] data_IE[1] data_OE[1] data_PU[1] data_PD[1] data_OUT[1] data_PDRV0[1] data_PDRV1[1] data_CS[2] data_SL[2] data_IE[2] data_OE[2] data_PU[2] data_PD[2] data_OUT[2] data_PDRV0[2] data_PDRV1[2] data_CS[3] data_SL[3] data_IE[3] data_OE[3] data_PU[3] data_PD[3] data_OUT[3] data_PDRV0[3] data_PDRV1[3] addr_PU[0] addr_PD[0] addr_PU[1] addr_PD[1] addr_PU[2] addr_PD[2] addr_PU[3] addr_PD[3] irq_CS irq_SL irq_IE irq_OE irq_PU irq_PD irq_OUT irq_PDRV0 irq_PDRV1 re_PU re_PD debug_state_CS[0] debug_state_SL[0] debug_state_IE[0] debug_state_OE[0] debug_state_PU[0] debug_state_PD[0] debug_state_OUT[0] debug_state_PDRV0[0] debug_state_PDRV1[0] debug_state_CS[2] debug_state_SL[2] debug_state_IE[2] debug_state_OE[2] debug_state_PU[2] debug_state_PD[2] debug_state_OUT[2] debug_state_PDRV0[2] debug_state_PDRV1[2] debug_state_CS[1] debug_state_SL[1] debug_state_IE[1] debug_state_OE[1] debug_state_PU[1] debug_state_PD[1] debug_state_OUT[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 | 0: | 0:
A06 | A06_BH_top_wrapper | A06_BH_top_wrapper.gds | 1110 | 550 | TRUE | OK |  | BH | 16 | 1:VDD | 1:VSS | 0: | 0: | 8:clk spi_in0 spi_in1 spi_in2 spi_in3 load_row_or_col input_ready output_valid | 1:rst_n | 5:spi_out0 spi_out1 spi_out2 spi_out3 output_ready | 0: | 1774:clknet_0_clk clknet_3_0_0_clk clknet_3_1_0_clk clknet_3_2_0_clk clknet_3_3_0_clk clknet_3_4_0_clk clknet_3_5_0_clk clknet_3_6_0_clk clknet_3_7_0_clk clknet_4_0__leaf_clk clknet_4_10__leaf_clk clknet_4_11__leaf_clk clknet_4_12__leaf_clk clknet_4_13__leaf_clk clknet_4_14__leaf_clk clknet_4_15__leaf_clk clknet_4_1__leaf_clk clknet_4_2__leaf_clk clknet_4_3__leaf_clk clknet_4_4__leaf_clk clknet_4_5__leaf_clk clknet_4_6__leaf_clk clknet_4_7__leaf_clk clknet_4_8__leaf_clk clknet_4_9__leaf_clk clknet_leaf_0_clk clknet_leaf_100_clk clknet_leaf_101_clk clknet_leaf_102_clk clknet_leaf_103_clk clknet_leaf_104_clk clknet_leaf_105_clk clknet_leaf_106_clk clknet_leaf_107_clk clknet_leaf_108_clk clknet_leaf_109_clk clknet_leaf_10_clk clknet_leaf_110_clk clknet_leaf_111_clk clknet_leaf_112_clk clknet_leaf_113_clk clknet_leaf_114_clk clknet_leaf_115_clk clknet_leaf_116_clk clknet_leaf_117_clk clknet_leaf_119_clk clknet_leaf_11_clk clknet_leaf_120_clk clknet_leaf_121_clk clknet_leaf_122_clk clknet_leaf_123_clk clknet_leaf_124_clk clknet_leaf_125_clk clknet_leaf_126_clk clknet_leaf_127_clk clknet_leaf_128_clk clknet_leaf_129_clk clknet_leaf_12_clk clknet_leaf_130_clk clknet_leaf_131_clk clknet_leaf_132_clk clknet_leaf_133_clk clknet_leaf_134_clk clknet_leaf_135_clk clknet_leaf_136_clk clknet_leaf_137_clk clknet_leaf_138_clk clknet_leaf_139_clk clknet_leaf_13_clk clknet_leaf_140_clk clknet_leaf_141_clk clknet_leaf_143_clk clknet_leaf_144_clk clknet_leaf_145_clk clknet_leaf_146_clk clknet_l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
A07 | A07_dcim_top | A07_dcim_top.gds | 1110 | 1110 | TRUE | OK |  | A | 14 | 1:VDD | 1:VSS | 0: | 0: | 8:rst_n a_bit w_bit start cont P_minus1[0] P_minus1[1] P_minus1[2] | 1:clk | 3:y_bit done busy | 0: | 0:
A09 | A09_BV | A09_BV.gds | 550 | 1110 | TRUE | OK |  | BV | 13 | 1:VDD | 1:VSS | 0: | 0: | 2:rst_n uart_rx | 1:clk | 8:uart_tx qspi_csn[0] qspi_csn[1] qspi_sck qspi_io[0] qspi_io[1] qspi_io[2] qspi_io[3] | 0: | 0:
A10 | A10_A | A10_A.gds | 1110 | 1110 | TRUE | OK |  | A | 8 | 1:VDD | 1:VSS | 0: | 0: | 0: | 0: | 0: | 6:clk rst_n sclk mosi cs_n miso | 0:
A12 | grouper_soc_chip_core | grouper_soc_chip_core.gds | 1650 | 1100 | FALSE | OK |  | ACV | 22 | 1:VDD | 1:VSS | 0: | 0: | 1:uart_rx | 2:clk rst_n | 17:uart_tx *gpio_0 *gpio_1 *gpio_2 *gpio_3 *gpio_4 *gpio_5 *gpio_6 *gpio_7 *gpio_8 *gpio_9 *gpio_10 *gpio_11 *gpio_12 *gpio_13 *gpio_14 *gpio_15 | 0: | 128:gpio_0_bidir_cs gpio_0_bidir_ie gpio_0_bidir_in gpio_0_bidir_oe gpio_0_bidir_out gpio_0_bidir_pd gpio_0_bidir_pu gpio_0_bidir_sl gpio_10_bidir_cs gpio_10_bidir_ie gpio_10_bidir_in gpio_10_bidir_oe gpio_10_bidir_out gpio_10_bidir_pd gpio_10_bidir_pu gpio_10_bidir_sl gpio_11_bidir_cs gpio_11_bidir_ie gpio_11_bidir_in gpio_11_bidir_oe gpio_11_bidir_out gpio_11_bidir_pd gpio_11_bidir_pu gpio_11_bidir_sl gpio_12_bidir_cs gpio_12_bidir_ie gpio_12_bidir_in gpio_12_bidir_oe gpio_12_bidir_out gpio_12_bidir_pd gpio_12_bidir_pu gpio_12_bidir_sl gpio_13_bidir_cs gpio_13_bidir_ie gpio_13_bidir_in gpio_13_bidir_oe gpio_13_bidir_out gpio_13_bidir_pd gpio_13_bidir_pu gpio_13_bidir_sl gpio_14_bidir_cs gpio_14_bidir_ie gpio_14_bidir_in gpio_14_bidir_oe gpio_14_bidir_out gpio_14_bidir_pd gpio_14_bidir_pu gpio_14_bidir_sl gpio_15_bidir_cs gpio_15_bidir_ie gpio_15_bidir_in gpio_15_bidir_oe gpio_15_bidir_out gpio_15_bidir_pd gpio_15_bidir_pu gpio_15_bidir_sl gpio_1_bidir_cs gpio_1_bidir_ie gpio_1_bidir_in gpio_1_bidir_oe gpio_1_bidir_out gpio_1_bidir_pd gpio_1_bidir_pu gpio_1_bidir_sl gpio_2_bidir_cs gpio_2_bidir_ie gpio_2_bidir_in gpio_2_bidir_oe gpio_2_bidir_out gpio_2_bidir_pd gpio_2_bidir_pu gpio_2_bidir_sl gpio_3_bidir_cs gpio_3_bidir_ie gpio_3_bidir_in gpio_3_bidir_oe gpio_3_bidir_out gpio_3_bidir_pd gpio_3_bidir_pu gpio_3_bidir_sl gpio_4_bidir_cs gpio_4_bidir_ie gpio_4_bidir_in gpio_4_bidir_oe gpio_4_bidir_out gpio_4_bidir_pd gpio_4_bidir_pu gpio_4_bidir_sl gpio_5_bidir_cs gpio_5_bidi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 | missing gpio_0_IN|gpio_0_OUT; missing gpio_1_IN|gpio_1_OUT; missing gpio_2_IN|gpio_2_OUT; missing gpio_3_IN|gpio_3_OUT; missing gpio_4_IN|gpio_4_OUT; missing gpio_5_IN|gpio_5_OUT; missing gpio_6_IN|gpio_6_OUT; missing gpio_7_IN|gpio_7_OUT; missing gpio_8_IN|gpio_8_OUT; missing gpio_9_IN|gpio_9_OUT; missing gpio_10_IN|gpio_10_OUT; missing gpio_11_IN|gpio_11_OUT; missing gpio_12_IN|gpio_12_OUT; missing gpio_13_IN|gpio_13_OUT; missing gpio_14_IN|gpio_14_OUT; missing gpio_15_IN|gpio_15_OUT
A13 | adc_top | adc_chip_top.gds | 514.25 | 549.7 | FALSE | OK |  | BV | 14 | 1:VDD | 1:VSS | 0: | 1:VIN | 1:RST_N | 1:CLK | 9:EOC BIT_0 BIT_1 BIT_2 BIT_3 BIT_4 BIT_5 BIT_6 BIT_7 | 0: | 0:
A19 | chip_top | chip_top.gds | 2084 | 2084 | FALSE |  |  | ACE2 | 32 | 1:VDD | 1:VSS | 11:*W09_NC *W10_NC *W12_NC *W13_NC *W15_NC *W16_NC *N01_NC *N02_NC *N03_NC *N04_NC *N13_NC | 0: | 6:*rst_n *a_valid_i *a_last_i *b_valid_i *b_last_i *out_ready_i | 1:*clk | 0: | 12:*a_ready_o *b_ready_o *data[0] *data[1] *data[2] *data[3] *data[4] *data[5] *data[6] *data[7] *out_valid_o *out_last_o | 20:analog_PAD bidir_PAD[0] bidir_PAD[10] bidir_PAD[11] bidir_PAD[1] bidir_PAD[2] bidir_PAD[3] bidir_PAD[4] bidir_PAD[5] bidir_PAD[6] bidir_PAD[7] bidir_PAD[8] bidir_PAD[9] clk_PAD input_PAD[0] input_PAD[1] input_PAD[2] input_PAD[3] input_PAD[4] rst_n_PAD | missing W09_NC; missing W10_NC; missing rst_n; missing W12_NC; missing W13_NC; missing clk; missing W15_NC; missing W16_NC; missing a_valid_i; missing a_last_i; missing a_ready_o_IN|a_ready_o_OUT; missing b_valid_i; missing b_last_i; missing b_ready_o_IN|b_ready_o_OUT; missing N01_NC; missing N02_NC; missing N03_NC; missing N04_NC; missing data_IN[0]|data_OUT[0]; missing data_IN[1]|data_OUT[1]; missing data_IN[2]|data_OUT[2]; missing data_IN[3]|data_OUT[3]; missing data_IN[4]|data_OUT[4]; missing data_IN[5]|data_OUT[5]; missing data_IN[6]|data_OUT[6]; missing data_IN[7]|data_OUT[7]; missing N13_NC; missing out_valid_o_IN|out_valid_o_OUT; missing out_last_o_IN|out_last_o_OUT; missing out_ready_i
A20 | system_top | system_top.gds | 1100 | 550 | FALSE | OK |  | BH | 9 | 1:*vdd | 1:*vss | 0: | 0: | 6:clk rst_n uart_rx mosi sck cs_n | 0: | 0: | 1:miso | 2:VDD VSS | missing vss; missing vdd
A23 | sar_adc_10b | sar_adc_10b.gds |  |  | FALSE |  |  |  | 18 | 1:VDD | 1:VSS | 0: | 3:Vin VRP VRN | 2:CLK SAMP | 0: | 11:B[9] B[8] B[7] B[6] B[5] B[4] B[3] B[2] B[1] B[0] eoc | 0: | 0: | TOP_LAYOUT 'sar_adc_10b' has no top-level shapes on layer 0/datatype 0
A28 | bgr_top_firstcut | bgr_top_firstcut.gds |  |  | FALSE |  |  |  | 0 | 0: | 0: | 0: | 0: | 0: | 0: | 0: | 0: | 0: | info.yaml does not contain a pin list (expected 'pins' or 'project.pins'); TOP_LAYOUT 'bgr_top_firstcut' has no top-level shapes on layer 0/datatype 0
A30 | qspi_chip_top | qspi_chip_top.gds | 1100 | 1100 | FALSE | OK |  | A | 18 | 1:VDD | 1:VSS | 0: | 0: | 1:reset | 1:clk | 2:uart_rx spi_miso | 12:spi_data0 spi_data1 spi_data2 spi_data3 spi_clk_out spi_flash_select spi_ram_a_select uart_tx spi_select disp_spi_clk_out spi_mosi spi_dc | 0:
A34 | chip_core | chip_core.gds | 1675 | 1675 | TRUE | OK |  | ACE | 16 | 1:VDD | 1:VSS | 0: | 0: | 9:clk input_in_0 input_in_1 input_in_2 input_in_3 input_in_4 input_in_5 input_in_6 input_in_7 | 1:rst_n | 4:output_out_0 output_out_1 output_out_2 output_out_3 | 0: | 0:
A37 | integration_final | integration_final.gds | 1000 | 1000 | FALSE | OK |  | A | 6 | 1:VDD | 1:VSS | 0: | 0: | 3:i_clk i_rst_n i_uart_rx | 0: | 1:o_uart_tx | 0: | 0:
A40 | trouper_top | trouper_top.gds | 1650 | 1100 | FALSE | OK |  | ACV | 25 | 1:VDD | 1:VSS | 0: | 0: | 10:IQ_DATA_I_0 IQ_DATA_Q_0 IQ_DATA_I_1 IQ_DATA_Q_1 IQ_DATA_I_2 IQ_DATA_Q_2 IQ_DATA_I_3 IQ_DATA_Q_3 IQ_CLK SPI_MOSI | 3:RESETB HOST_CS SPI_SCK | 9:REMOD_A_I REMOD_A_Q PSRAM_CE_N *PSRAM_SIO_0 *PSRAM_SIO_1 *PSRAM_SIO_2 *PSRAM_SIO_3 SPI_MISO IRQ_OUT | 1:PSRAM_SCK | 40:GRP_ADDR_0 GRP_ADDR_1 GRP_ADDR_2 GRP_ADDR_3 GRP_ADDR_4 GRP_ADDR_5 GRP_ADDR_6 GRP_ADDR_7 GRP_RDATA_0 GRP_RDATA_1 GRP_RDATA_2 GRP_RDATA_3 GRP_RDATA_4 GRP_RDATA_5 GRP_RDATA_6 GRP_RDATA_7 GRP_RE GRP_READY GRP_WDATA_0 GRP_WDATA_1 GRP_WDATA_2 GRP_WDATA_3 GRP_WDATA_4 GRP_WDATA_5 GRP_WDATA_6 GRP_WDATA_7 GRP_WE IRQ_GROUPER PSRAM_SIO_IN_0 PSRAM_SIO_IN_1 PSRAM_SIO_IN_2 PSRAM_SIO_IN_3 PSRAM_SIO_OE_0 PSRAM_SIO_OE_1 PSRAM_SIO_OE_2 PSRAM_SIO_OE_3 PSRAM_SIO_OUT_0 PSRAM_SIO_OUT_1 PSRAM_SIO_OUT_2 PSRAM_SIO_OUT_3 | missing PSRAM_SIO_0_IN|PSRAM_SIO_0_OUT; missing PSRAM_SIO_1_IN|PSRAM_SIO_1_OUT; missing PSRAM_SIO_2_IN|PSRAM_SIO_2_OUT; missing PSRAM_SIO_3_IN|PSRAM_SIO_3_OUT
A43 | ic_top_usb_audio | ic_top_usb_audio.gds | 1400 | 500 | FALSE | OK |  | ACV | 10 | 1:VDD | 1:VSS | 1:*AUDIO_OUT_L | 0: | 2:RESET_N *DAC_FB_IN_L | 1:SYS_CLK_60M | 4:USB_DP_PULL DAC_MOD_OUT_L USB_DP USB_DN | 0: | 0: | missing AUDIO_OUT_L; missing DAC_FB_IN_L
A44 | A44_SAR_ADC_CORE_1000_R3_DUMMY_FILL_REPAIR | A44_SAR_ADC_CORE_1000.gds | 1000 | 1000 | FALSE | OK |  | A | 15 | 1:VDD | 1:GND | 0: | 4:VREFN VINN VINP VREFP | 1:CLKS | 0: | 8:DOUT[7] DOUT[6] DOUT[5] DOUT[4] DOUT[3] DOUT[2] DOUT[1] DOUT[0] | 0: | 20:CLKS_CORE CMPCK DCMPN DCMPP DCTRLN[1] DCTRLN[2] DCTRLN[3] DCTRLN[4] DCTRLN[5] DCTRLN[6] DCTRLN[7] DCTRLP[1] DCTRLP[2] DCTRLP[3] DCTRLP[4] DCTRLP[5] DCTRLP[6] DCTRLP[7] VFON VFOP
A45 | chip_top_full | chip_top_full.gds | 1100 | 1100 | FALSE |  |  | A | 22 | 1:VDD | 1:VSS | 0: | 0: | 9:clk_int scan_in scan_shift scan_load scan_i0o1 gpio_in[0] gpio_in[1] uart_rx spi_miso | 2:clk rst_n | 9:scan_out gpio_out[0] gpio_out[1] gpio_out[2] gpio_out[3] uart_tx spi_sclk spi_mosi spi_cs_n | 0: | 0:
A48 | trc_top | trc_top.gds | 550 | 550 | TRUE |  |  | D | 9 | 1:VDD | 1:VSS | 0: | 0: | 3:iRST iSPI_CS iSPI_MOSI | 2:iCLK iSPI_SCK | 2:oSPI_MISO oINTERRUPT | 0: | 0:
A49 | sar_adc_top | sar_adc_top.gds |  |  | FALSE | OK |  |  | 14 | 1:vdd | 1:vss | 0: | 2:vref vin | 0: | 1:start | 9:done dout[0] dout[1] dout[2] dout[3] dout[4] dout[5] dout[6] dout[7] | 0: | 0: | no layer 0/datatype 0 exists in GDS for TOP_LAYOUT 'sar_adc_top'
A53 | A53_trng_top | A53_trng_top.gds | 535.23 | 533.55 | FALSE | OK |  | D | 10 | 1:VDD | 1:GND | 2:vin_vco analog_raw_out | 0: | 4:rst_n clk test_data_in test_mode_en | 0: | 2:data_serial_out bist_flag_out | 0: | 0:
A54 | lstm16x_top | lstm16x_top.gds | 1000 | 1000 | FALSE | OK |  | A | 22 | 1:VDD | 1:VSS | 0: | 0: | 9:cmd_valid cmd_data[0] cmd_data[1] cmd_data[2] cmd_data[3] cmd_data[4] cmd_data[5] cmd_data[6] cmd_data[7] | 2:clk rst_n | 9:rsp_data[0] rsp_data[1] rsp_data[2] rsp_data[3] rsp_data[4] rsp_data[5] rsp_data[6] rsp_data[7] rsp_valid | 0: | 0:
A56 | dla_engine_chip | dla_engine_chip.gds | 1675 | 1110 | TRUE | OK |  | ACV | 11 | 1:DVDD | 1:DVSS | 0: | 0: | 1:rst_n | 1:clk | 0: | 7:SCLK MOSI CS_N MISO busy done wb_done | 0:
A63 | spi_opentarget_i3c_top | spi_opentarget_i3c_top.gds | 450 | 450 | FALSE | OK |  | BV | 12 | 1:VDD | 1:VSS | 0: | 0: | 7:rst_ni clk_i host_clk_i spi_sclk_i spi_cs_ni spi_mosi_i scl_pad_i | 0: | 3:spi_miso_o *sda_pad irq_o | 0: | 2:sda_pad_i sda_pad_o | missing sda_pad_IN|sda_pad_OUT
A64 | fdda_top | fdda_top.gds | 278.44 | 160.66 | FALSE | OK |  | D | 8 | 1:VDD_3v3 | 1:GND | 0: | 6:Vnn Vnp Vpp Vpn Von Vop | 0: | 0: | 0: | 0: | 16:1a 1b 2a 2b 3a 3b 5 7 8 Bias_aux CM_neg CM_pos Gbias_20u_n Gbias_20u_p Vcm Vcmfb
A66 | PLL_top | PLL_top.gds | 500 | 500 | FALSE | OK |  | D | 10 | 1:*vdd | 1:*vss | 0: | 1:*Vctrl | 0: | 3:*Fref *SDA *SCL | 4:*CK0 *CK90 *CK180 *CK270 | 0: | 0: | missing CK0_IN|CK0_OUT; missing CK90_IN|CK90_OUT; missing CK180_IN|CK180_OUT; missing CK270_IN|CK270_OUT; missing Fref; missing Vctrl; missing SDA; missing SCL; missing vdd; missing vss
A68 | ascon_top | ascon_top.gds | 1000 | 1000 | FALSE | OK |  | A | 8 | 1:VDD | 1:VSS | 0: | 0: | 3:rst cs_n mosi | 2:clk sclk | 1:miso | 0:
A71 | lambda_kv_coproc | lambda_kv_coproc.gds | 502.89 | 520.81 | FALSE |  |  | BV | 12 | 1:VDD | 1:VSS | 0: | 0: | 4:rst_n spi_sclk spi_cs_n spi_mosi | 1:clk | 5:spi_miso obs0 obs1 obs2 obs3 | 0: | 0:
B02 | ABC123_SDC | ABC123_SDC.gds |  |  | FALSE |  |  |  | 15 | 1:VDD_1 | 1:VSS_1 | 2:CSENS CREF | 1:VCTRL | 7:CAPBANK[0] CAPBANK[1] CAPBANK[2] DFF_IN_SEL DFF_IN1 DFF_IN2 CHOP | 0: | 3:CCOSENS_OUT CCOREF_OUT DOUT | 0: | 0: | TOP_LAYOUT cell 'ABC123_SDC' not found in GDS
B04 | B04_TOP | B04_TOP.gds | 1110 | 1110 | TRUE | OK |  | A | 10 | 1:VDD | 1:GND | 0: | 4:Vin Vbpf Venvelope Vthreshold | 1:en | 1:scl | 2:Vtrigger sda | 0: | 0:
B08 | TOP | TOP.gds | 251.93 | 279.4 | FALSE |  |  |  | 0 | 0: | 0: | 0: | 0: | 0: | 0: | 0: | 0: | 0: | pin entry 5 ('CLK') has unsupported pad type 'digital'
B11 | B11_CuriousIC_DryRun_Top | B11_CuriousIC_DryRun_Top_26Aug.gds | 600 | 600 | FALSE | OK |  | A | 22 | 2:*B11_BMS_DVDD *B11_BMS_AVDD | 2:*B11_BMS_DVSS *B11_BMS_AVSS | 6:*B11_BMS_VINN_CH1 *B11_BMS_VINP_CH1 *B11_BMS_VREFP *B11_BMS_IBIAS_5u *B11_BMS_VCM *B11_BMS_ATB_IA_ADC | 0: | 10:*B11_BMS_CLKIN *B11_BMS_CLK_FCHOP *B11_BMS_EN_EIS *B11_BMS_EIS_RESET *B11_BMS_CH_SEL *B11_BMS_ATB_SEL_0 *B11_BMS_ATB_SEL_1 *B11_BMS_D_EIS *B11_BMS_CLK_EIS *B11_BMS_DOUT | 0: | 2:*B11_BMS_VINN_CH2 *B11_BMS_VINP_CH2 | 0: | 0: | missing B11_BMS_DVSS; missing B11_BMS_CLKIN; missing B11_BMS_CLK_FCHOP; missing B11_BMS_DVDD; missing B11_BMS_VINN_CH1; missing B11_BMS_VINP_CH1; missing B11_BMS_VREFP; missing B11_BMS_IBIAS_5u; missing B11_BMS_VCM; missing B11_BMS_VINN_CH2_IN|B11_BMS_VINN_CH2_OUT; missing B11_BMS_VINP_CH2_IN|B11_BMS_VINP_CH2_OUT; missing B11_BMS_EN_EIS; missing B11_BMS_EIS_RESET; missing B11_BMS_AVSS; missing B11_BMS_AVDD; missing B11_BMS_CH_SEL; missing B11_BMS_ATB_SEL_0; missing B11_BMS_ATB_SEL_1; missing B11_BMS_D_EIS; missing B11_BMS_CLK_EIS; missing B11_BMS_ATB_IA_ADC; missing B11_BMS_DOUT
B12 | perceptron | perceptron.gds | 135.81 | 138.87 | FALSE | OK |  | D | 9 | 1:VDD | 1:VSS | 0: | 7:V_w2 I_x2 V_b I_x1 V_w1 V_shift V_out_perceptron | 0: | 0: | 0: | 0: | 0:
B14 | B14_A | B14_A.gds | 1110 | 1110 | TRUE | OK |  | A | 18 | 1:VDD | 1:VSS | 5:VREF_P VREF_N RE TIA_R CE | 11:B6 B4 B2 B0 B1 B3 B5 B7 VbiasN AGND WE | 0: | 0: | 0: | 0: | 0:
B18 | B18_Probton | B18_Probton.gds | 1110 | 1110 | TRUE | OK |  | A | 19 | 1:VDD | 1:VSS | 0: | 0: | 4:spi_sclk clk comp_x comp_y | 3:rst_n spi_cs_n spi_mosi | 10:spi_miso move_en_x dir_x ref_wave_x mems_drv_x mems_drv_y ref_wave_y dir_y move_en_y read_en | 0: | 0:
B23 | B23_TEMPX_DryRun_Top | B23_TempX.gds | 600 | 600 | FALSE |  |  | A | 14 | 2:*AVDD *DVDD | 2:*AGND *DGND | 0: | 0: | 6:*CLK *RESET *ENABLE *TEST_SEL_2 *TEST_SEL_1 *TEST_SEL_0 | 0: | 4:*DATA_OUT *DATA_VALID *TEST_ANALOG *TEST_OUT | 0: | 0: | missing AGND; missing AVDD; missing DVDD; missing DGND; missing CLK; missing RESET; missing ENABLE; missing TEST_SEL_2; missing TEST_SEL_1; missing TEST_SEL_0; missing DATA_OUT_IN|DATA_OUT_OUT; missing DATA_VALID_IN|DATA_VALID_OUT; missing TEST_ANALOG_IN|TEST_ANALOG_OUT; missing TEST_OUT_IN|TEST_OUT_OUT
B24 | B24_topcell | B24_topcell.gds |  |  | FALSE | OK |  |  | 18 | 2:VSET VDD | 1:GND | 0: | 15:Ibias LED_K Comparator_out HPF_outp HPF_outn HPF_inp HPF_inn Vb1 Vb2 Vb3 Vb4 LPF_outp LPF_outn LPF_inp LPF_inn | 0: | 0: | 0: | 0: | 0: | group 2 missing ground: VDD HPF_outp HPF_outn HPF_inp HPF_inn Vb1 Vb2 Vb3 Vb4 LPF_outp LPF_outn LPF_inp LPF_inn; TOP_LAYOUT cell 'B24_topcell' not found in GDS
B26 | GRADIENT_NAV2 | GRADIENT_NAV2_filled.gds | 418.24 | 442.19 | FALSE | OK |  | A | 19 | 1:VDD | 1:VSS | 0: | 11:S4P S4N Z Y X S1N S1P S3P S3N S2N S2P | 0: | 0: | 6:ZN ZP YN YP XN XP | 0: | 0:
B29 | TopFinal | TopFinal.gds |  |  | FALSE |  |  |  | 0 | 0: | 0: | 0: | 0: | 0: | 0: | 0: | 0: | 0: | pin entry 9 ('Vmem') has unsupported pad type 'output'; TOP_LAYOUT cell 'TopFinal' not found in GDS
C01 | DUT | DUT.gds | 1110 | 1110 | TRUE | OK | Approved | A | 18 | 1:VDD | 1:VSS | 12:INP_TELESCOPIC INP_FOLDED OUT_TELESCOPIC OUT_FOLDED INP_5T INN_TELESCOPIC INN_FOLDED IBIAS IN_CS OUT_CS INN_5T OUT_5T | 0: | 3:PROG_ENA SCAN_IN CLK | 0: | 1:SCAN_OUT | 0: | 0:
C04 | DUT | DUT.gds |  |  | FALSE |  |  |  | 0 | 0: | 0: | 0: | 0: | 0: | 0: | 0: | 0: | 0: | analog pin entry 16 ('SCDAC2_OUT') does not specify whether secondary ESD protection is used; Stream has unknown format: /Users/kanobailey/chipathon/2026/gds/C04/DUT.gds in Layout.read
C05 | ota_gds | ota_gds.gds |  |  | FALSE | OK |  |  | 0 | 0: | 0: | 0: | 0: | 0: | 0: | 0: | 0: | 0: | info.yaml does not contain a pin list (expected 'pins' or 'project.pins'); TOP_LAYOUT cell 'ota_gds' not found in GDS
D03 | butterfold_top | butterfold_top.gds | 1092.66 | 1119.54 | FALSE |  |  | ACH | 23 | 1:VDD | 1:VSS | 0: | 0: | 10:rst_n din_valid_i din[7] din[6] din[5] din[4] din[3] din[2] din[1] din[0] | 1:clk | 10:din_ready_o dout_valid_o dout[7] dout[6] dout[5] dout[4] dout[3] dout[2] dout[1] dout[0] | 0: | 0:
D04 | NanoCGRA_Lite | nanocgra_lite_3x3_opt_filled.gds | 466.555 | 466.555 | FALSE | OK |  | E | 6 | 1:*vdd | 1:*vss | 0: | 0: | 1:uart_rx | 2:clk rst_n | 1:*uart_tx | 0: | 0: | missing vss; missing uart_tx_IN|uart_tx_OUT; missing vdd
D05 | rf_energy_harvester$1 | harvester_top_full.gds | 287.07 | 290.71 | FALSE | OK | Approved | E | 5 | 1:*VCC | 1:VSS | 3:RFP RFN VOUT | 0: | 0: | 0: | 0: | 0: | 5:N1 N2 VMID1 VMID2 VRECT | missing VCC
D10 | D10_D | D10_D.gds | 550 | 550 | TRUE | OK | Approved | D | 9 | 1:VDD | 1:VSS | 0: | 0: | 4:rst_n din load_en shift_out_en | 1:clk | 2:dout done | 0: | 0:
D15 | mosaic_block_a | mosaic_block_a.gds | 1110 | 1110 | TRUE | OK | Approved | A | 22 | 1:VDD | 1:VSS | 0: | 0: | 4:rst_ni boot_select_i execute_from_flash_i uart_rx_i | 1:clk_i | 15:uart_tx_o spi_flash_sck_o spi_flash_cs_o spi_flash_sd_io[0] spi_flash_sd_io[1] spi_flash_sd_io[2] spi_flash_sd_io[3] status_valid_o status_o[0] status_o[1] status_o[2] status_o[3] status_o[4] status_o[5] status_o[6] | 0: | 0:
D16 | top_pd_min_logiconly_qspi_areaopt2 | top_pd_min_logiconly_qspi_areaopt2.gds | 950.695 | 968.615 | FALSE |  |  |  | 18 | 1:VDD | 1:VSS | 0: | 0: | 2:rst_ni uart_rx_i | 1:clk_i | 13:uart_tx_o uart_tx_en_o qspi_sclk_o qspi_cs_n_o qspi_io_o[0] qspi_io_o[1] qspi_io_o[2] qspi_io_o[3] qspi_io_i[0] qspi_io_i[1] qspi_io_i[2] qspi_io_i[3] qspi_io_oe_o | 0: | 0:
 |  |  |  |  |  |  |  |  |  | Chip | A | ACE | ACE2 | ACH | ACV | BH | BV | D | Utilization
 |  |  |  | A | 7 | 7 | 2 | 16 |  | 1 |  | 1 |  |  | 1 | 1 | 1 |  | 118.75%
 |  |  |  | ACE | 1 | 1 | 0 | 1 |  | 2 |  | 1 |  |  | 1 | 1 | 1 |  | 118.75%
 |  |  |  | ACE2 | 0 | 0 | 0 | 1 |  | 3 | 3 |  |  |  |  | 1 |  |  | 87.50%
 |  |  |  | ACH | 0 | 0 | 0 | 1 |  | 4 | 2 |  | 1 |  |  | 1 |  |  | 150.00%
 |  |  |  | ACV | 1 | 1 | 0 | 4 |  | 5 |  |  |  | 2 |  |  |  |  | 75.00%
 |  |  |  | BH | 2 | 2 | 0 | 3 |  | 6 | 2 |  |  | 1 |  |  |  |  | 87.50%
 |  |  |  | BV | 1 | 1 | 0 | 4 |  | 7 | 4 |  |  |  |  |  |  |  | 100.00%
 |  |  |  | D | 2 | 1 | 1 | 6 |  | 8 | 3 |  |  |  |  |  |  |  | 75.00%
 |  |  |  | E | 0 | 0 | 0 | 2 |  | 9 |  |  |  |  |  |  |  |  | 0.00%
 |  |  |  | X | 1 | 1 | 0 | 1 |  | 10 |  |  |  |  |  |  |  |  | 0.00%
 |  |  |  |  | 15 | 14 | 3 | 38 | Projects | 28 | 14 | 2 | 1 | 3 | 2 | 4 | 2 | 0
 |  |  |  | Zero pins: |  |  |  |  | 5
 |  |  |  | No bbox |  |  |  |  | 8
 |  |  |  | Invalid bbox |  |  |  |  | 26 |  |  |  |  |  |  |  |  |  | Unused
 |  |  |  |  |  |  |  |  |  | Utilization | 25.00% | 56.25% | 87.50% | 37.50% | 37.50% | 12.50% | 12.50% | 6.25% | -0.125
 |  |  |  |  |  |  |  |  |  |  |  |  |  |  |  |  |  |  | -1.6%

Sheet: Export
 |  |  |  | is it EAR99?
A02 AI_Byte | A02 | yte
A06 BUETCHIP | A06 | HIP
A64 UFJF On Chip | A64 | hip
A07 Blueprints | A07 | nts
B18 Probton | B18 | ton
C05 MRTMOS | C05 | MOS
A12 Grouper A12 | A12 | A12
D10 SystemsGenesys (D10) | D10 | 10) | D10
A37 TensorGrid (A37) | A37 | 37) | A37
A10 CryptoAccel | A10 | cel
A63 Technocrats | A63 | ats
B11 CuriousIC | B11 | sIC
B12 Electron Ensemble | B12 | ble
B22 Space Jam | B22 | Jam
A53 - Iris Labs Hardware | A53 | are
D04 Chip Orchstra (D04 ) | D04 | 4 ) | D04
D05 Gelochip | D05 | hip
A68 elka1 (A68) | A68 | 68) | A68
A20 MisterKebab (A20) | A20 | 20) | A20
A43] XLR8 | A43 | LR8
A49 Berkah Saluyu | A49 | uyu
B04_AURA | B04 | URA
D05 Gelochip (D05) | D05 | 05) | D05
A56 Finding SRAM | A56 | RAM
A09 Crispi | A09 | spi
B05 Acoustic Ranger | B05 | ger
A34 SiliconForge(A34) | A34 | 34) | A34
B14 MX_UPP_INAOE | B14 | AOE
A58 Capibara Convolucional | A58 | nal
A66 SynChronos | A66 | nos
D08 - Microelectronic Block Generator | D08 | tor
A40 Trouper | A40 | per
A01 — AUS/NZ Track A RFIC | A01 | FIC
A44 JST | A44 | JST
C01 Four-Topology MOSbius (C01) | C01 | 01) | C01
A13 Hungry Chippos [A13] | A13 | 13]
SAR ADC | SAR | ADC
A54 Waibibabu | A54 | abu
A30 SILICON_RISC-V | A30 | C-V
B26 Zonetic B26 | B26 | B26
B24 The Chip Wizards | B24 | rds
D15 JustVibeAndTapeout (D15) | D15 | 15) | D15

Sheet: Status
Team | Track lead | Status
A01
A02
A06
A07
A09
A10
A12
A13
A19
A20
A23
A28
A30
A34
A37
A40
A43
A44
A45
A48
A49
A53
A54
A56
A63
A64
A66
A68
A71
B02
B04
B08
B11
B12
B14
B18
B23
B24
B26
B29
C01 | Luighi | Approved
C04
C05
D03
D04
D05 | Luighi | Approved
D10 | Luighi | Approved
D15 | Luighi | Approved
D16

Sheet: download log
A01 | Zachnad0/AUS-NZ-Track-A-RFIC-Workspace
A01 | Zachnad0/AUS-NZ-Track-A-RFIC-Workspace
info.yaml | info/A01_info.yaml
lvs_config | lvs/lvs_config.json
TOP_LAYOUT | chip_top
LAYOUT_FILE | gds/chip_top.gds
GDS saved | gds/A01/chip_top.gds
A02 | setup99/chipathon-2026-AI_Byte
info.yaml | info/A02_info.yaml
lvs_config | lvs_config.json
TOP_LAYOUT | A02_A
LAYOUT_FILE | gds/A02_A.gds
GDS saved | gds/A02/A02_A.gds
A06 | mqrnknoetonoob/MarkovChip
info.yaml | info/A06_info.yaml
lvs_config | lvs_config.json
TOP_LAYOUT | A06_BH_top_wrapper
LAYOUT_FILE | Physical_Design/After_Padring_Integration/RUN_A06_BH_WRAPPED_FINAL/results/final/gds/A06_BH_top_wrapper.gds
GDS saved | gds/A06/A06_BH_top_wrapper.gds
A07 | ratshgupta-guptar76/blueprints
info.yaml | info/A07_info.yaml
lvs_config | lvs_config.json
TOP_LAYOUT | A07_dcim_top
LAYOUT_FILE | gds/A07_dcim_top.gds
GDS saved | gds/A07/A07_dcim_top.gds
A09 | irfannhlm/OpenQSPI_Chipathon2026
info.yaml | info/A09_info.yaml
lvs_config | lvs_config.json
TOP_LAYOUT | A09_BV
LAYOUT_FILE | layout/chipathon26-template/macros/A09_BV/final/gds/A09_BV.gds
GDS saved | gds/A09/A09_BV.gds
A10 | lakshmikiyer/Chipathon-2026-A10_Cryptoaccel
info.yaml | info/A10_info.yaml
lvs_config | lvs_config.json
TOP_LAYOUT | A10_A
LAYOUT_FILE | Integration_with_def/Runs/final/gds/A10_A.gds
GDS saved | gds/A10/A10_A.gds
A12 | Sheffield-Chip-Design-Team/chipathon-2026-grouper
info.yaml | info/A12_info.yaml
lvs_config | librelane/classic/lvs_config.json
TOP_LAYOUT | grouper_soc_chip_core
LAYOUT_FILE | final/gds/grouper_soc_chip_core.gds
GDS saved | gds/A12/grouper_soc_chip_core.gds
A13 | brubru6707/hungry-chippos-chipathon-2026
info.yaml | info/A13_info.yaml
lvs_config | lvs_config.json
TOP_LAYOUT | adc_top
LAYOUT_FILE | adc_top/layout/adc_chip_top.gds
GDS saved | gds/A13/adc_chip_top.gds
A19 | Amal-K-Anil/Systolic-Tensor-Accelerator
info.yaml | info/A19_info.yaml
lvs_config | lvs_config.json
TOP_LAYOUT | chip_top
LAYOUT_FILE | gds/chip_top.gds
GDS saved | gds/A19/chip_top.gds
A20 | 2Charts/chipathon26-A20-FIR_Filter
info.yaml | info/A20_info.yaml
lvs_config | lvs_config.json
TOP_LAYOUT | system_top
LAYOUT_FILE | final/gds/system_top.gds
GDS saved | gds/A20/system_top.gds
A23 | Gior-gio/Chipathon-2026-OnChipSAR
info.yaml | info/A23_info.yaml
lvs_config | lvs_config.json
TOP_LAYOUT | sar_adc_10b
LAYOUT_FILE | designs/sar_adc/top/sar_adc_10b/gds/sar_adc_10b.gds
GDS saved | gds/A23/sar_adc_10b.gds
A25 | elnaggar/Open-Silicon-10-Bit-SAR-ADC
ERROR | info.yaml not found in elnaggar/Open-Silicon-10-Bit-SAR-ADC on the main branch
A28 | Rani340/chipathon-2026-Silicon_BGR
info.yaml | info/A28_info.yaml
lvs_config | lvs_config.json
TOP_LAYOUT | bgr_top_firstcut
LAYOUT_FILE | gds/bgr_top_firstcut.gds
GDS saved | gds/A28/bgr_top_firstcut.gds
A30 | dev65808/chipathon-2026-SILICON_RISC-V
info.yaml | info/A30_info.yaml
lvs_config | lvs_config.json
TOP_LAYOUT | qspi_chip_top
LAYOUT_FILE | gds/qspi_chip_top.gds
GDS saved | gds/A30/qspi_chip_top.gds
A34 | Waleed99i/chipathon-2026-systolic-ip-core
info.yaml | info/A34_info.yaml
lvs_config | lvs_config.json
TOP_LAYOUT | chip_core
LAYOUT_FILE | gds/chip_core.gds
GDS saved | gds/A34/chip_core.gds
A36 | felixrdtke/A36
info.yaml | info/A36_info.yaml
lvs_config | <relative-path-to-lvs_config.json>
ERROR | <relative-path-to-lvs_config.json> not found in felixrdtke/A36 on the main branch
A37 | KBdeGaulle1803/TensorGrid
info.yaml | info/A37_info.yaml
lvs_config | lvs_config.json
TOP_LAYOUT | integration_final
LAYOUT_FILE | physical/librelane/final/gds/integration_final.gds
GDS saved | gds/A37/integration_final.gds
A38 | EngGhaith/The-Silent-Owl-GF180MCU-WB-LNA
ERROR | info.yaml not found in EngGhaith/The-Silent-Owl-GF180MCU-WB-LNA on the main branch
A40 | Sheffield-Chip-Design-Team/chipathon-2026-trouper
info.yaml | info/A40_info.yaml
lvs_config | lvs_config.json
TOP_LAYOUT | trouper_top
LAYOUT_FILE | final/gds/trouper_top.gds
GDS saved | gds/A40/trouper_top.gds
A43 | Gotawa-Aryo/usb-audio-system-ic
info.yaml | info/A43_info.yaml
lvs_config | lvs_config.json
TOP_LAYOUT | ic_top_usb_audio
LAYOUT_FILE | layout/gds/ic_top_usb_audio.gds
GDS saved | gds/A43/ic_top_usb_audio.gds
A44 | tritone4801/chipathon-2026-A44-SAR-ADC
info.yaml | info/A44_info.yaml
lvs_config | lvs_config.json
TOP_LAYOUT | A44_SAR_ADC_CORE_1000_R3_DUMMY_FILL_REPAIR
LAYOUT_FILE | gds/A44_SAR_ADC_CORE_1000.gds
GDS saved | gds/A44/A44_SAR_ADC_CORE_1000.gds
A45 | farihahahmed/pico-soc
info.yaml | info/A45_info.yaml
lvs_config | lvs_config.json
TOP_LAYOUT | chip_top_full
LAYOUT_FILE | gds/chip_top_full.gds
GDS saved | gds/A45/chip_top_full.gds
A48 | byanarvendy/chipathon-2026-adaptive-multi-trc-fault-injection-detection-core-circuit
info.yaml | info/A48_info.yaml
lvs_config | lvs_config.json
TOP_LAYOUT | trc_top
LAYOUT_FILE | gds/trc_top.gds
GDS saved | gds/A48/trc_top.gds
A49 | arazax/chipathon26-SAR_ADC
info.yaml | info/A49_info.yaml
lvs_config | lvs_config.json
TOP_LAYOUT | sar_adc_top
LAYOUT_FILE | layout/sar_adc/sar_adc_top.gds
GDS saved | gds/A49/sar_adc_top.gds
A52 | rafiihsanalfathin123/low-power-12b-first-order-delta-sigma-adc
info.yaml | info/A52_info.yaml
lvs_config | lvs_config.json
TOP_LAYOUT | fullydiffamp$2
LAYOUT_FILE | src/layout/fullydiffamp/fullydiffamp_routed.gds
ERROR | src/layout/fullydiffamp/fullydiffamp_routed.gds not found in rafiihsanalfathin123/low-power-12b-first-order-delta-sigma-adc on the main branch
A53 | adulu-bang/chipathon-2026-gf180mcu-padring
info.yaml | info/A53_info.yaml
lvs_config | lvs_config.json
TOP_LAYOUT | A53_trng_top
LAYOUT_FILE | gds/A53_trng_top.gds
GDS saved | gds/A53/A53_trng_top.gds
A54 | hankchen0326/A54_LSTM-based_text_recognition_ML_accelerator_chipathon-2026-gf180mcu
info.yaml | info/A54_info.yaml
lvs_config | lvs_config.json
TOP_LAYOUT | lstm16x_top
LAYOUT_FILE | gds/lstm16x_top.gds
GDS saved | gds/A54/lstm16x_top.gds
A56 | mpa216/Deep-Learning-Accelerator-DLA-Engine-From-CNN-to-GenAI-SNN
info.yaml | info/A56_info.yaml
lvs_config | lvs_config.json
TOP_LAYOUT | dla_engine_chip
LAYOUT_FILE | gds/dla_engine_chip.gds
GDS saved | gds/A56/dla_engine_chip.gds
A58 | ral298/convChip_chipaton
info.yaml | info/A58_info.yaml
lvs_config | lvs_config.json>
ERROR | lvs_config.json> not found in ral298/convChip_chipaton on the main branch
A59 | mena-04/FalconFoundry
ERROR | info.yaml not found in mena-04/FalconFoundry on the main branch
A61 | valerineabc/chipathon-2026-wwc
ERROR | info.yaml not found in valerineabc/chipathon-2026-wwc on the main branch
A63 | Free-95/OpenTarget-I3C
info.yaml | info/A63_info.yaml
lvs_config | lvs_config.json
TOP_LAYOUT | spi_opentarget_i3c_top
LAYOUT_FILE | gds/spi_opentarget_i3c_top.gds
GDS saved | gds/A63/spi_opentarget_i3c_top.gds
A64 | estevao741/chipathon-2026-fdda
info.yaml | info/A64_info.yaml
lvs_config | lvs_config.json
TOP_LAYOUT | fdda_top
LAYOUT_FILE | src/gds/fdda_top.gds
GDS saved | gds/A64/fdda_top.gds
A66 | yohanesstef/synchronos-chipathon-2026
info.yaml | info/A66_info.yaml
lvs_config | lvs_config.json
TOP_LAYOUT | PLL_top
LAYOUT_FILE | designs/libs/gds_archive/PLL_top.gds
GDS saved | gds/A66/PLL_top.gds
A68 | MarcoYeremia/ASCON-AEAD-128-for-power-constraint-embedded-system
info.yaml | info/A68_info.yaml
lvs_config | lvs_config.json
TOP_LAYOUT | ascon_top
LAYOUT_FILE | gds/ascon_top.gds
GDS saved | gds/A68/ascon_top.gds
A71 | LonghornSilicon/gf180-longhorn-tiu
info.yaml | info/A71_info.yaml
lvs_config | lvs_config.json
TOP_LAYOUT | lambda_kv_coproc
LAYOUT_FILE | gds/lambda_kv_coproc.gds
GDS saved | gds/A71/lambda_kv_coproc.gds
B02 | JorgeMarinN/SSCS-Chipathon-2026_ABC123-team
info.yaml | info/B02_info.yaml
lvs_config | ABC123_SDC/design_data/lvs/lvs_config.json
TOP_LAYOUT | ABC123_SDC
LAYOUT_FILE | ABC123_SDC/design_data/gds/ABC123_SDC.gds
GDS saved | gds/B02/ABC123_SDC.gds
B04 | dfirman15/AURA-Event-Driven-Mixed-Signal-ASIC-for-Acoustic-Pattern-Detection
info.yaml | info/B04_info.yaml
lvs_config | lvs_config.json
TOP_LAYOUT | B04_TOP
LAYOUT_FILE | gds/B04_TOP.gds
GDS saved | gds/B04/B04_TOP.gds
B05 | radityankn/acoustic-ranger-dvl-processor
info.yaml | info/B05_info.yaml
lvs_config | lvs_config.json
TOP_LAYOUT | A01_topcell
LAYOUT_FILE | gds/A01_topcell.gds
ERROR | gds/A01_topcell.gds not found in radityankn/acoustic-ranger-dvl-processor on the main branch
B07 | AutoMOS-project/AutoMOS-chipathon2026
info.yaml | info/B07_info.yaml
lvs_config | lvs_config.json
ERROR | lvs_config.json not found in AutoMOS-project/AutoMOS-chipathon2026 on the main branch
B08 | Varchaswin/Biosignal-Foundry
info.yaml | info/B08_info.yaml
lvs_config | lvs_config.json
TOP_LAYOUT | TOP
LAYOUT_FILE | gds/TOP/TOP.gds
GDS saved | gds/B08/TOP.gds
B11 | guptasou03/B11_CuriousIC_BMS
info.yaml | info/B11_info.yaml
lvs_config | lvs_config.json
TOP_LAYOUT | B11_CuriousIC_DryRun_Top
LAYOUT_FILE | B11_CuriousIC_DryRun_Top_26Aug.gds
GDS saved | gds/B11/B11_CuriousIC_DryRun_Top_26Aug.gds
B12 | valrek-sol/analog-perceptron-gf180mcu
info.yaml | info/B12_info.yaml
lvs_config | lvs/lvs_config.json
TOP_LAYOUT | perceptron
LAYOUT_FILE | gds/perceptron.gds
GDS saved | gds/B12/perceptron.gds
B14 | lucaalsi/B14-MX_UPP_INAOE
info.yaml | info/B14_info.yaml
lvs_config | lvs_config.json
TOP_LAYOUT | B14_A
LAYOUT_FILE | gds/B14_A.gds
GDS saved | gds/B14/B14_A.gds
B18 | llhtimlam/Probton
info.yaml | info/B18_info.yaml
lvs_config | lvs/lvs_config.json
TOP_LAYOUT | B18_Probton
LAYOUT_FILE | gds/B18_Probton.gds
GDS saved | gds/B18/B18_Probton.gds
B23 | Jimena0601/-Track--B-Bandgap-Temp-Sensor
info.yaml | info/B23_info.yaml
lvs_config | lvs_config.json
TOP_LAYOUT | B23_TEMPX_DryRun_Top
LAYOUT_FILE | B23_TempX.gds
GDS saved | gds/B23/B23_TempX.gds
B24 | jacklzhu7/chipathon-2026-ppg
info.yaml | info/B24_info.yaml
lvs_config | lvs_config.json
TOP_LAYOUT | B24_topcell
LAYOUT_FILE | B24_topcell.gds
GDS saved | gds/B24/B24_topcell.gds
B26 | AnBuiUCI/sscs-2026-zotnetic
info.yaml | info/B26_info.yaml
lvs_config | lvs_config.json
TOP_LAYOUT | GRADIENT_NAV2
LAYOUT_FILE | FINAL/openroad/out_v2_GRADIENT_NAV2/GRADIENT_NAV2_filled.gds
GDS saved | gds/B26/GRADIENT_NAV2_filled.gds
B29 | Andika236/Adaptive-Neuromorphic-E-Skin-Readout-IC
info.yaml | info/B29_info.yaml
lvs_config | lvs_config.json
TOP_LAYOUT | TopFinal
LAYOUT_FILE | TopFinal.gds
GDS saved | gds/B29/TopFinal.gds
C01 | elijohnsonn/Four-Topology-MOSbius
info.yaml | info/C01_info.yaml
lvs_config | DRC_dry_run/lvs_config.json
TOP_LAYOUT | DUT
LAYOUT_FILE | designs/libs/core_tb/layout/DUT.gds
GDS saved | gds/C01/DUT.gds
C04 | yutaka-kotani-stj/2026_sscs_gf180
info.yaml | info/C04_info.yaml
lvs_config | DRC_dry_run/lvs_config.json
TOP_LAYOUT | DUT
LAYOUT_FILE | designs/libs/core_tb/layout/DUT.gds
GDS saved | gds/C04/DUT.gds
C05 | madhavgulati277/SSCS-Chipathon-Track-C-MOSbius
info.yaml | info/C05_info.yaml
lvs_config | dry_run/lvs_config.json
TOP_LAYOUT | ota_gds
LAYOUT_FILE | dry_run/ota_gds.gds
GDS saved | gds/C05/ota_gds.gds
D03 | aravindustries/butterfold
info.yaml | info/D03_info.yaml
lvs_config | lvs_config.json
TOP_LAYOUT | butterfold_top
LAYOUT_FILE | gds/butterfold_top.gds
GDS saved | gds/D03/butterfold_top.gds
D04 | radhian/Chip-Orchestra
info.yaml | info/D04_info.yaml
lvs_config | output/nanocgra_lite_3x3_opt/lvs_config.json
TOP_LAYOUT | NanoCGRA_Lite
LAYOUT_FILE | output/nanocgra_lite_3x3_opt/gds/nanocgra_lite_3x3_opt_filled.gds
GDS saved | gds/D04/nanocgra_lite_3x3_opt_filled.gds
D05 | adeirman46/Gelochip
info.yaml | info/D05_info.yaml
lvs_config | lvs_config.json
TOP_LAYOUT | rf_energy_harvester$1
LAYOUT_FILE | report/rf_harvester_signoff_out/harvester_top_full.gds
GDS saved | gds/D05/harvester_top_full.gds
D08 | mthudaa/Microelectronic-Block-Generator
info.yaml | info/D08_info.yaml
lvs_config | lvs_config_mbg_d08.json
ERROR | lvs_config_mbg_d08.json not found in mthudaa/Microelectronic-Block-Generator on the main branch
D10 | Lefteris-B/Chipathon_2026_Secure_agentic_chip_design
info.yaml | info/D10_info.yaml
lvs_config | lvs_config.json
TOP_LAYOUT | D10_D
LAYOUT_FILE | gds/D10_D.gds
GDS saved | gds/D10/D10_D.gds
D14 | AlejandroJuarezLora/CapiMagics
info.yaml | info/D14_info.yaml
lvs_config | designs/libs/snn_analog/lvs_config.json
TOP_LAYOUT | D14_topcell
LAYOUT_FILE | gds/D14_topcell.gds
ERROR | gds/D14_topcell.gds not found in AlejandroJuarezLora/CapiMagics on the main branch
D15 | MILOUDIAS/MOSAIC-SoC
info.yaml | info/D15_info.yaml
lvs_config | lvs_config.json
TOP_LAYOUT | mosaic_block_a
LAYOUT_FILE | flow/librelane/experimental/runs/blocka_padframe_def/final/gds/mosaic_block_a.gds
GDS saved | gds/D15/mosaic_block_a.gds
D16 | alex-j-wang/low-power-RoT
info.yaml | info/D16_info.yaml
lvs_config | lvs_config.json
TOP_LAYOUT | top_pd_min_logiconly_qspi_areaopt2
LAYOUT_FILE | gds/top_pd_min_logiconly_qspi_areaopt2.gds
GDS saved | gds/D16/top_pd_min_logiconly_qspi_areaopt2.gds
Successful | 49
Failed | 11

Sheet: Blocks
Blocks | Pin order | Placement | Pin count | width | height | Area | block | utilization
E | W12-W17 | 350, 1475 | 6 | 550 | 550 | 302500 |  | 6.25%
D | W18-W22,N01-N05 | 350, 2035 | 10 | 550 | 550 | 302500 |  | 6.25%
CH | W12-W17 | 350, 1475 | 6 | 1110 | 550 | 610500 |  | 12.50%
CV | N06-N11 | 910, 1475 | 6 | 550 | 1110 | 610500 |  | 12.50%
BV | W12-W22,N01-N05 | 350, 1475 | 16 | 550 | 1110 | 610500 |  | 12.50%
BH | W18-W22,N01-N11 | 350, 2035 | 16 | 1110 | 550 | 610500 |  | 12.50%
A | W12-W22,N01-N11 | 350, 1475 | 22 | 1110 | 1110 | 1232100 |  | 25.00%
ACV | W12-W22,N01-N16 | 350, 1475 | 27 | 1675 | 1110 | 1859250 |  | 37.50%
ACH | W07-W22,N01-N11 | 350, 910 | 27 | 1110 | 1675 | 1859250 |  | 37.50%
ACE | W07-W22,N01-N16 | 350, 910 | 32 | 1675 | 1675 | 2805625 |  | 56.25%
ACE2 | W07-W22,N01-N16,E16-E01,S22-S07 | 350, 350 | 64 | 2235 | 2235 | 5308750 | 0,0-560,560 & 1675,1675-2235,2235 | 87.50%
See Chipathon 2026 padframe proposal for details (https://docs.google.com/presentation/d/1Xv_e0r1JKkjAIttDKGDsLEcDNz211jee_gQeWR6n7Es/edit?usp=sharing)

Sheet: Problems
A12: missing gpio_0_IN|gpio_0_OUT
A12: missing gpio_1_IN|gpio_1_OUT
A12: missing gpio_2_IN|gpio_2_OUT
A12: missing gpio_3_IN|gpio_3_OUT
A12: missing gpio_4_IN|gpio_4_OUT
A12: missing gpio_5_IN|gpio_5_OUT
A12: missing gpio_6_IN|gpio_6_OUT
A12: missing gpio_7_IN|gpio_7_OUT
A12: missing gpio_8_IN|gpio_8_OUT
A12: missing gpio_9_IN|gpio_9_OUT
A12: missing gpio_10_IN|gpio_10_OUT
A12: missing gpio_11_IN|gpio_11_OUT
A12: missing gpio_12_IN|gpio_12_OUT
A12: missing gpio_13_IN|gpio_13_OUT
A12: missing gpio_14_IN|gpio_14_OUT
A12: missing gpio_15_IN|gpio_15_OUT
A19: missing W09_NC
A19: missing W10_NC
A19: missing rst_n
A19: missing W12_NC
A19: missing W13_NC
A19: missing clk
A19: missing W15_NC
A19: missing W16_NC
A19: missing a_valid_i
A19: missing a_last_i
A19: missing a_ready_o_IN|a_ready_o_OUT
A19: missing b_valid_i
A19: missing b_last_i
A19: missing b_ready_o_IN|b_ready_o_OUT
A19: missing N01_NC
A19: missing N02_NC
A19: missing N03_NC
A19: missing N04_NC
A19: missing data_IN[0]|data_OUT[0]
A19: missing data_IN[1]|data_OUT[1]
A19: missing data_IN[2]|data_OUT[2]
A19: missing data_IN[3]|data_OUT[3]
A19: missing data_IN[4]|data_OUT[4]
A19: missing data_IN[5]|data_OUT[5]
A19: missing data_IN[6]|data_OUT[6]
A19: missing data_IN[7]|data_OUT[7]
A19: missing N13_NC
A19: missing out_valid_o_IN|out_valid_o_OUT
A19: missing out_last_o_IN|out_last_o_OUT
A19: missing out_ready_i
A20: missing vss
A20: missing vdd
A23: TOP_LAYOUT 'sar_adc_10b' has no top-level shapes on layer 0/datatype 0
A28: info.yaml does not contain a pin list (expected 'pins' or 'project.pins')
A28: TOP_LAYOUT 'bgr_top_firstcut' has no top-level shapes on layer 0/datatype 0
A40: missing PSRAM_SIO_0_IN|PSRAM_SIO_0_OUT
A40: missing PSRAM_SIO_1_IN|PSRAM_SIO_1_OUT
A40: missing PSRAM_SIO_2_IN|PSRAM_SIO_2_OUT
A40: missing PSRAM_SIO_3_IN|PSRAM_SIO_3_OUT
A43: missing AUDIO_OUT_L
A43: missing DAC_FB_IN_L
A49: no layer 0/datatype 0 exists in GDS for TOP_LAYOUT 'sar_adc_top'
A63: missing sda_pad_IN|sda_pad_OUT
A66: missing CK0_IN|CK0_OUT
A66: missing CK90_IN|CK90_OUT
A66: missing CK180_IN|CK180_OUT
A66: missing CK270_IN|CK270_OUT
A66: missing Fref
A66: missing Vctrl
A66: missing SDA
A66: missing SCL
A66: missing vdd
A66: missing vss
B02: TOP_LAYOUT cell 'ABC123_SDC' not found in GDS
B08: pin entry 5 ('CLK') has unsupported pad type 'digital'
B11: missing B11_BMS_DVSS
B11: missing B11_BMS_CLKIN
B11: missing B11_BMS_CLK_FCHOP
B11: missing B11_BMS_DVDD
B11: missing B11_BMS_VINN_CH1
B11: missing B11_BMS_VINP_CH1
B11: missing B11_BMS_VREFP
B11: missing B11_BMS_IBIAS_5u
B11: missing B11_BMS_VCM
B11: missing B11_BMS_VINN_CH2_IN|B11_BMS_VINN_CH2_OUT
B11: missing B11_BMS_VINP_CH2_IN|B11_BMS_VINP_CH2_OUT
B11: missing B11_BMS_EN_EIS
B11: missing B11_BMS_EIS_RESET
B11: missing B11_BMS_AVSS
B11: missing B11_BMS_AVDD
B11: missing B11_BMS_CH_SEL
B11: missing B11_BMS_ATB_SEL_0
B11: missing B11_BMS_ATB_SEL_1
B11: missing B11_BMS_D_EIS
B11: missing B11_BMS_CLK_EIS
B11: missing B11_BMS_ATB_IA_ADC
B11: missing B11_BMS_DOUT
B23: missing AGND
B23: missing AVDD
B23: missing DVDD
B23: missing DGND
B23: missing CLK
B23: missing RESET
B23: missing ENABLE
B23: missing TEST_SEL_2
B23: missing TEST_SEL_1
B23: missing TEST_SEL_0
B23: missing DATA_OUT_IN|DATA_OUT_OUT
B23: missing DATA_VALID_IN|DATA_VALID_OUT
B23: missing TEST_ANALOG_IN|TEST_ANALOG_OUT
B23: missing TEST_OUT_IN|TEST_OUT_OUT
B24: group 2 missing ground: VDD HPF_outp HPF_outn HPF_inp HPF_inn Vb1 Vb2 Vb3 Vb4 LPF_outp LPF_outn LPF_inp LPF_inn
B24: TOP_LAYOUT cell 'B24_topcell' not found in GDS
B29: pin entry 9 ('Vmem') has unsupported pad type 'output'
B29: TOP_LAYOUT cell 'TopFinal' not found in GDS
C04: analog pin entry 16 ('SCDAC2_OUT') does not specify whether secondary ESD protection is used
C04: Stream has unknown format: /Users/kanobailey/chipathon/2026/gds/C04/DUT.gds in Layout.read
C05: info.yaml does not contain a pin list (expected 'pins' or 'project.pins')
C05: TOP_LAYOUT cell 'ota_gds' not found in GDS
D04: missing vss
D04: missing uart_tx_IN|uart_tx_OUT
D04: missing vdd
D05: missing VCC
