mpa216/Deep-Learning-Accelerator-DLA-Engine-From-CNN-to-GenAI-SNN/3V3lib/gf180mcu_ocd_io-main/docs/specs/21_Characterization_Corners.csv

oProcess corner | DVDD(V) | Temperature( C)
SS | 4.5 | 125
FF | 5.5 | -40
TT | 5 | 25
FF* | 5.5 | 125
SS | 2.97 | 125
FF | 3.63 | -40
TT | 3.3 | 25
FF* | 3.63 | 125
SS | 2.25 | 125
FF | 2.75 | -40
TT | 2.5 | 25
FF* | 2.75 | 125
