mpa216/Deep-Learning-Accelerator-DLA-Engine-From-CNN-to-GenAI-SNN/SRAM_MACRO/gf180mcu_ocd_ip_sram-main/cells/gf180mcu_ocd_ip_sram__sram64x8m8wm1/specs/5_AC_Characteristics1.csv

Symbol | Parameter Description | SNSP Process 4.5v, -40C | SNSP Process 4.5v, 125C | Typical Process 5.0v, 25C | FNFP Process 5.5v, 125C | FNFP Process 5.5v, -40C | unit
Tcyc | Min clock period | 7.5946 | 11 | 6.1181 | 5.6608 | 3.957 | ns
Tckh | Min clock high time | 3.3401 | 5.4009 | 2.6907 | 2.0829 | 1.4546 | ns
Tckl | Min clock low time | 3.5036 | 4.9693 | 2.6661 | 1.9737 | 1.5862 | ns
Tcsl | CEN set up time ( CEN = L ) | 0.4584 | 0.5869 | 0.406 | 0.3883 | 0.3228 | ns
Tchl | CEN hold time ( CEN = L ) | 1.2328 | 1.8527 | 1.1081 | 1.0768 | 0.7655 | ns
Tcsh | CEN set up time ( CEN = H ) | 0.5124 | 0.6616 | 0.435 | 0.411 | 0.3369 | ns
Tchh | CEN hold time ( CEN = H ) | 1.2868 | 1.9188 | 1.1371 | 1.0995 | 0.7797 | ns
Twsl | GWEN set up time ( GWEN = L ) | 0.718 | 1.0143 | 0.6281 | 0.5888 | 0.4541 | ns
Twhl | GWEN hold time ( GWEN = L ) | 1.0062 | 1.3936 | 0.8467 | 0.8056 | 0.6051 | ns
Twsh | GWEN set up time ( GWEN = H ) | 0.6753 | 0.9358 | 0.5903 | 0.5619 | 0.4329 | ns
Twhh | GWEN hold time ( GWEN = H ) | 0.5421 | 0.712 | 0.4752 | 0.4717 | 0.3744 | ns
Twisl | WEN set up time ( WEN = L ) | 0.2681 | 0.3326 | 0.2552 | 0.2318 | 0.2132 | ns
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
