mpa216/Deep-Learning-Accelerator-DLA-Engine-From-CNN-to-GenAI-SNN/SRAM_MACRO/gf180mcu_ocd_ip_sram-main/cells/gf180mcu_ocd_ip_sram__sram64x8m8wm1/specs/5_AC_Characteristics2.csv

Symbol | Parameter description | SNSP Process 3.0v, -40C | SNSP Process 3.0, 125C | Typical Process 3.3v, 25C | FNFP Process 3.6v, 125C | FNFP Process 3.6v, -40C | unit
Tcyc | Min clock period | 11.6044 | 17.0863 | 8.5597 | 7.3978 | 5.1007 | ns
Tckh | Min clock high time | 4.1518 | 5.1878 | 3.2873 | 2.8975 | 1.8998 | ns
Tckl | Min clock low time | 4.2752 | 6.2768 | 3.891 | 2.9738 | 1.8573 | ns
Tcsl | CEN set up time ( CEN = L ) | 0.6591 | 0.8517 | 0.542 | 0.4951 | 0.4047 | ns
Tchl | CEN hold time ( CEN = L ) | 1.9054 | 2.849 | 1.592 | 1.4784 | 1.0184 | ns
Tcsh | CEN set up time ( CEN = H ) | 0.8058 | 1.0775 | 0.6175 | 0.5341 | 0.4262 | ns
Tchh | CEN hold time ( CEN = H ) | 2.0065 | 2.9742 | 1.64 | 1.5046 | 1.0375 | ns
Twsl | GWEN set up time ( GWEN = L ) | 1.1586 | 1.6455 | 0.9198 | 0.8113 | 0.6012 | ns
Twhl | GWEN hold time ( GWEN = L ) | 1.4693 | 2.0948 | 1.1528 | 1.039 | 0.7639 | ns
Twsh | GWEN set up time ( GWEN = H ) | 1.0285 | 1.4295 | 0.8241 | 0.741 | 0.5578 | ns
Twhh | GWEN hold time ( GWEN = H ) | 0.7347 | 1.0252 | 0.6061 | 0.5779 | 0.4516 | ns
Twisl | WEN set up time ( WEN = L ) | 0.4276 | 0.4945 | 0.36 | 0.3185 | 0.2767 | ns
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
