mpa216/Deep-Learning-Accelerator-DLA-Engine-From-CNN-to-GenAI-SNN/SRAM_MACRO/gf180mcu_ocd_ip_sram-main/cells/gf180mcu_ocd_ip_sram__sram64x8m8wm1/specs/5_AC_Characteristics3.csv

Symbol | Parameter description | SNSP Process 1.62v, -40C | SNSP Process 1.62v, 125C | Typical Process 1.8v, 25C | FNFP Process 1.98v, 125C | FNFP Process 1.98v, -40C | unit
Tcyc | Min clock period | 49.6236 | 53.6235 | 22.4703 | 14.439 | 10.5548 | ns
Tckh | Min clock high time | 18.4434 | 25.7785 | 10.9148 | 3.8319 | 4.6646 | ns
Tckl | Min clock low time | 24.2445 | 20.8014 | 10.2887 | 5.3502 | 4.7431 | ns
Tcsl | CEN set up time ( CEN = L ) | 2.3681 | 2.4651 | 1.1518 | 0.7912 | 0.6521 | ns
Tchl | CEN hold time ( CEN = L ) | 7.2637 | 8.1415 | 3.8285 | 2.745 | 1.9932 | ns
Tcsh | CEN set up time ( CEN = H ) | 3.5818 | 3.6043 | 1.5568 | 0.9701 | 0.7982 | ns
Tchh | CEN hold time ( CEN = H ) | 8.1245 | 8.8521 | 4.0462 | 2.8098 | 2.0519 | ns
Twsl | GWEN set up time ( GWEN = L ) | 5.3918 | 5.595 | 2.4131 | 1.5312 | 1.1886 | ns
Twhl | GWEN hold time ( GWEN = L ) | 6.6902 | 7.1843 | 2.641 | 1.7922 | 1.3425 | ns
Twsh | GWEN set up time ( GWEN = H ) | 3.788 | 4.1484 | 1.8898 | 1.3037 | 1.0054 | ns
Twhh | GWEN hold time ( GWEN = H ) | 3.9825 | 4.2086 | 1.3454 | 0.9058 | 0.7109 | ns
Twisl | WEN set up time ( WEN = L ) | 0 | 0 | 0.635 | 0.5269 | 0.4594 | ns
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
