mpa216/Deep-Learning-Accelerator-DLA-Engine-From-CNN-to-GenAI-SNN/3V3lib/gf180mcu_ocd_io-main/netlist/schematic/gf180mcu_ocd_io__brk2.spice

** sch_path: /home/tim/gitsrc/open_pdks/sources/gf180mcu_ocd_io/cells/brk2/gf180mcu_ocd_io__brk2.sch
.subckt gf180mcu_ocd_io__brk2 VSS
*.PININFO VSS:B
* noconn VSS
.ends
