mpa216/Deep-Learning-Accelerator-DLA-Engine-From-CNN-to-GenAI-SNN/3V3lib/gf180mcu_ocd_io-main/netlist/schematic/gf180mcu_ocd_io__fill10.spice

** sch_path: /home/tim/gitsrc/open_pdks/sources/gf180mcu_ocd_io/cells/fill10/gf180mcu_ocd_io__fill10.sch
.subckt gf180mcu_ocd_io__fill10 DVDD DVSS VDD VSS
*.PININFO DVDD:B DVSS:B VDD:B VSS:B
* noconn VDD
* noconn VSS
* noconn DVDD
* noconn DVSS
.ends
