mpa216/Deep-Learning-Accelerator-DLA-Engine-From-CNN-to-GenAI-SNN/3V3lib/gf180mcu_ocd_io-main/netlist/layout/gf180mcu_ocd_io__brk2.spice

* NGSPICE file created from gf180mcu_ocd_io__brk2.ext - technology: gf180mcuD

.subckt GF_NI_BRK2_1 VSS
.ends

.subckt GF_NI_BRK2_0 VSS
XGF_NI_BRK2_1_0 VSS GF_NI_BRK2_1
.ends

.subckt gf180mcu_ocd_io__brk2 VSS
XGF_NI_BRK2_0_0 VSS GF_NI_BRK2_0
.ends
