mpa216/Deep-Learning-Accelerator-DLA-Engine-From-CNN-to-GenAI-SNN/3V3lib/gf180mcu_ocd_io-main/netlist/layout/gf180mcu_ocd_io__cor.spice

* NGSPICE file created from gf180mcu_ocd_io__cor.ext - technology: gf180mcuD

.subckt moscap_corner_1 a_5519_6541# a_5519_529# a_4904_32#
X0 a_5519_529# a_4904_32# cap_nmos_06v0 c_width=25u c_length=10u
X1 a_5519_6541# a_4904_32# cap_nmos_06v0 c_width=25u c_length=10u
X2 a_5519_529# a_4904_32# cap_nmos_06v0 c_width=25u c_length=10u
X3 a_5519_6541# a_4904_32# cap_nmos_06v0 c_width=25u c_length=10u
.ends

.subckt moscap_corner VMINUS a_647_6541# a_647_529#
X0 a_647_6541# VMINUS cap_nmos_06v0 c_width=25u c_length=10u
X1 a_647_529# VMINUS cap_nmos_06v0 c_width=25u c_length=10u
X2 a_647_6541# VMINUS cap_nmos_06v0 c_width=25u c_length=10u
X3 a_647_529# VMINUS cap_nmos_06v0 c_width=25u c_length=10u
X4 a_647_529# VMINUS cap_nmos_06v0 c_width=25u c_length=10u
X5 a_647_6541# VMINUS cap_nmos_06v0 c_width=25u c_length=10u
X6 a_647_6541# VMINUS cap_nmos_06v0 c_width=25u c_length=10u
X7 a_647_529# VMINUS cap_nmos_06v0 c_width=25u c_length=10u
.ends

.subckt moscap_corner_2 VMINUS a_647_6541# a_5519_529#
X0 a_647_6541# VMINUS cap_nmos_06v0 c_width=25u c_length=10u
X1 a_5519_529# VMINUS cap_nmos_06v0 c_width=25u c_length=10u
X2 a_647_6541# VMINUS cap_nmos_06v0 c_width=25u c_length=10u
X3 a_5519_529# VMINUS cap_nmos_06v0 c_width=25u c_length=10u
X4 a_647_6541# VMINUS cap_nmos_06v0 c_width=25u c_length=10u
X5 a_647_6541# VMINUS cap_nmos_06v0 c_width=25u c_length=10u
.ends

.subckt nmos_clamp_20_50_4 a_582_632# w_n51_n51# a_1237_1481#
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
X35 top_route_0/VSUBS a_3781_27789# a_4685_27789# top_route_0/VSUBS nfet_06v0 ad=2.2p pd=10.88u as=1.3p ps=5.52u w=5u l=0.7u
X36 comp018green_esd_rc_v5p0_1_0/VPLUS a_3781_27789# a_4685_27789# comp018green_esd_rc_v5p0_1_0/VPLUS pfet_06v0 ad=1.3p pd=5.52u as=1.3p ps=5.52u w=5u l=0.7u
X37 comp018green_esd_rc_v5p0_1_0/VPLUS a_3781_27789# a_4685_27789# comp018green_esd_rc_v5p0_1_0/VPLUS pfet_06v0 ad=2.2p pd=10.88u as=1.3p ps=5.52u w=5u l=0.7u
X38 a_3781_27789# a_2805_27789# top_route_0/VSUBS top_route_0/VSUBS nfet_06v0 ad=1.3p pd=5.52u as=1.3p ps=5.52u w=5u l=0.7u
X39 top_route_0/VSUBS a_2805_27789# a_3781_27789# top_route_0/VSUBS nfet_06v0 ad=1.3p pd=5.52u as=1.3p ps=5.52u w=5u l=0.7u
X40 a_4685_27789# a_3781_27789# comp018green_esd_rc_v5p0_1_0/VPLUS comp018green_esd_rc_v5p0_1_0/VPLUS pfet_06v0 ad=1.3p pd=5.52u as=1.3p ps=5.52u w=5u l=0.7u
X41 a_3781_27789# a_2805_27789# comp018green_esd_rc_v5p0_1_0/VPLUS comp018green_esd_rc_v5p0_1_0/VPLUS pfet_06v0 ad=2.2p pd=10.88u as=1.3p ps=5.52u w=5u l=0.7u
X42 comp018green_esd_rc_v5p0_1_0/VPLUS a_3781_27789# a_4685_27789# comp018green_esd_rc_v5p0_1_0/VPLUS pfet_06v0 ad=1.3p pd=5.52u as=1.3p ps=5.52u w=5u l=0.7u
X43 a_4685_27789# a_3781_27789# comp018green_esd_rc_v5p0_1_0/VPLUS comp018green_esd_rc_v5p0_1_0/VPLUS pfet_06v0 ad=1.3p pd=5.52u as=1.3p ps=5.52u w=5u l=0.7u
.ends

.subckt comp018green_esd_rc_v5p0 VRC VPLUS VMINUS
X0 a_353_2269# a_13226_1989# VPLUS ppolyf_u r_width=0.8u r_length=63.855u
X1 VRC VMINUS cap_nmos_06v0 c_width=25u c_length=10u
X2 a_353_3389# a_13226_3109# VPLUS ppolyf_u r_width=0.8u r_length=63.855u
X3 a_353_2829# a_13226_3109# VPLUS ppolyf_u r_width=0.8u r_length=63.855u
X4 VRC VMINUS cap_nmos_06v0 c_width=25u c_length=10u
X5 a_353_1709# a_13226_1989# VPLUS ppolyf_u r_width=0.8u r_length=63.855u
X6 a_353_1709# a_13226_1429# VPLUS ppolyf_u r_width=0.8u r_length=63.855u
X7 a_353_2829# a_13226_2549# VPLUS ppolyf_u r_width=0.8u r_length=63.855u
X8 VRC VMINUS cap_nmos_06v0 c_width=25u c_length=10u
X9 VRC VMINUS cap_nmos_06v0 c_width=25u c_length=10u
X10 VRC a_13226_3669# VPLUS ppolyf_u r_width=0.8u r_length=63.855u
X11 VRC VMINUS cap_nmos_06v0 c_width=25u c_length=10u
X12 a_353_1149# a_13226_1429# VPLUS ppolyf_u r_width=0.8u r_length=63.855u
X13 VPLUS a_13226_869# VPLUS ppolyf_u r_width=0.8u r_length=63.855u
X14 a_353_2269# a_13226_2549# VPLUS ppolyf_u r_width=0.8u r_length=63.855u
X15 VRC VMINUS cap_nmos_06v0 c_width=25u c_length=10u
X16 a_353_3389# a_13226_3669# VPLUS ppolyf_u r_width=0.8u r_length=63.855u
X17 VRC VMINUS cap_nmos_06v0 c_width=25u c_length=10u
X18 VRC VMINUS cap_nmos_06v0 c_width=25u c_length=10u
X19 a_353_1149# a_13226_869# VPLUS ppolyf_u r_width=0.8u r_length=63.855u
.ends
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
