mpa216/Deep-Learning-Accelerator-DLA-Engine-From-CNN-to-GenAI-SNN/(list of files, drawings)

Other design files:
References_and_example/open-pdks-main/sky130/klayout/sky130.lyt
