mpa216/Deep-Learning-Accelerator-DLA-Engine-From-CNN-to-GenAI-SNN/layout_announcement/A56.def/A56/project_defs/ACV/A56_ACV_padring.v

module A56_ACV_padring (
    N01,
    N02,
    N03,
    N04,
    N05,
    N06,
    N07,
    N08,
    N09,
    N10,
    N11,
    N12,
    N13,
    N14,
    N15,
    N16,
    N17,
    N18,
    N19,
    N20,
    N21,
    N22,
    E01,
    E02,
    E03,
    E04,
    E05,
    E06,
    E07,
    E08,
    E09,
    E10,
    E11,
    E12,
    E13,
    E14,
    E15,
    E16,
    E17,
    E18,
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
    W12_PU,
    W12_PD,
    W12_Y,
    W13_PU,
    W13_PD,
    W13_Y,
    W14_CS,
    W14_SL,
    W14_IE,
    W14_OE,
    W14_PU,
    W14_PD,
    W14_A,
    W14_Y,
    W15_CS,
    W15_SL,
    W15_IE,
    W15_OE,
    W15_PU,
    W15_PD,
    W15_A,
    W15_Y,
    W16_CS,
    W16_SL,
    W16_IE,
    W16_OE,
    W16_PU,
    W16_PD,
    W16_A,
    W16_Y,
    W17_CS,
    W17_SL,
    W17_IE,
    W17_OE,
    W17_PU,
    W17_PD,
    W17_A,
    W17_Y,
    W18_CS,
    W18_SL,
    W18_IE,
    W18_OE,
    W18_PU,
    W18_PD,
    W18_A,
    W18_Y,
    W19_CS,
    W19_SL,
    W19_IE,
    W19_OE,
    W19_PU,
    W19_PD,
    W19_A,
    W19_Y,
    W20_CS,
    W20_SL,
    W20_IE,
    W20_OE,
    W20_PU,
    W20_PD,
    W20_A,
    W20_Y
);
  inout N01;
  inout N02;
  inout N03;
  inout N04;
  inout N05;
  inout N06;
  inout N07;
  inout N08;
  inout N09;
  inout N10;
  inout N11;
  inout N12;
  inout N13;
  inout N14;
  inout N15;
  inout N16;
  inout N17;
  inout N18;
  inout N19;
  inout N20;
  inout N21;
  inout N22;
  inout E01;
  inout E02;
  inout E03;
  inout E04;
  inout E05;
  inout E06;
  inout E07;
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
  gf180mcu_fd_io__asig_5p0 S05 (.ASIG5V(S05), .VSS(W22), .DVSS(W22), .VDD(W21), .DVDD(W21));
  gf180mcu_fd_io__asig_5p0 S06 (.ASIG5V(S06), .VSS(W22), .DVSS(W22), .VDD(W21), .DVDD(W21));
  gf180mcu_fd_io__asig_5p0 S07 (.ASIG5V(S07), .VSS(W22), .DVSS(W22), .VDD(W21), .DVDD(W21));
  gf180mcu_fd_io__asig_5p0 S08 (.ASIG5V(S08), .VSS(W22), .DVSS(W22), .VDD(W21), .DVDD(W21));
  gf180mcu_fd_io__asig_5p0 S09 (.ASIG5V(S09), .VSS(W22), .DVSS(W22), .VDD(W21), .DVDD(W21));
  gf180mcu_fd_io__asig_5p0 S10 (.ASIG5V(S10), .VSS(W22), .DVSS(W22), .VDD(W21), .DVDD(W21));
  gf180mcu_fd_io__asig_5p0 S11 (.ASIG5V(S11), .VSS(W22), .DVSS(W22), .VDD(W21), .DVDD(W21));
  gf180mcu_fd_io__asig_5p0 S12 (.ASIG5V(S12), .VSS(W22), .DVSS(W22), .VDD(W21), .DVDD(W21));
  gf180mcu_fd_io__asig_5p0 S13 (.ASIG5V(S13), .VSS(W22), .DVSS(W22), .VDD(W21), .DVDD(W21));
  gf180mcu_fd_io__asig_5p0 S14 (.ASIG5V(S14), .VSS(W22), .DVSS(W22), .VDD(W21), .DVDD(W21));
  gf180mcu_fd_io__asig_5p0 S15 (.ASIG5V(S15), .VSS(W22), .DVSS(W22), .VDD(W21), .DVDD(W21));
  gf180mcu_fd_io__asig_5p0 S16 (.ASIG5V(S16), .VSS(W22), .DVSS(W22), .VDD(W21), .DVDD(W21));
  gf180mcu_fd_io__asig_5p0 S17 (.ASIG5V(S17), .VSS(W22), .DVSS(W22), .VDD(W21), .DVDD(W21));
  gf180mcu_fd_io__asig_5p0 S18 (.ASIG5V(S18), .VSS(W22), .DVSS(W22), .VDD(W21), .DVDD(W21));
  gf180mcu_fd_io__asig_5p0 S19 (.ASIG5V(S19), .VSS(W22), .DVSS(W22), .VDD(W21), .DVDD(W21));
  gf180mcu_fd_io__asig_5p0 S20 (.ASIG5V(S20), .VSS(W22), .DVSS(W22), .VDD(W21), .DVDD(W21));
  gf180mcu_fd_io__asig_5p0 S21 (.ASIG5V(S21), .VSS(W22), .DVSS(W22), .VDD(W21), .DVDD(W21));
  gf180mcu_fd_io__asig_5p0 S22 (.ASIG5V(S22), .VSS(W22), .DVSS(W22), .VDD(W21), .DVDD(W21));
  gf180mcu_fd_io__asig_5p0 W01 (.ASIG5V(W01), .VSS(W22), .DVSS(W22), .VDD(W21), .DVDD(W21));
  gf180mcu_fd_io__asig_5p0 W02 (.ASIG5V(W02), .VSS(W22), .DVSS(W22), .VDD(W21), .DVDD(W21));
  gf180mcu_fd_io__asig_5p0 W03 (.ASIG5V(W03), .VSS(W22), .DVSS(W22), .VDD(W21), .DVDD(W21));
  gf180mcu_fd_io__asig_5p0 W04 (.ASIG5V(W04), .VSS(W22), .DVSS(W22), .VDD(W21), .DVDD(W21));
  gf180mcu_fd_io__asig_5p0 W05 (.ASIG5V(W05), .VSS(W22), .DVSS(W22), .VDD(W21), .DVDD(W21));
  gf180mcu_fd_io__asig_5p0 W06 (.ASIG5V(W06), .VSS(W22), .DVSS(W22), .VDD(W21), .DVDD(W21));
  gf180mcu_fd_io__asig_5p0 W07 (.ASIG5V(W07), .VSS(W22), .DVSS(W22), .VDD(W21), .DVDD(W21));
  gf180mcu_fd_io__asig_5p0 W08 (.ASIG5V(W08), .VSS(W22), .DVSS(W22), .VDD(W21), .DVDD(W21));
  gf180mcu_fd_io__asig_5p0 W09 (.ASIG5V(W09), .VSS(W22), .DVSS(W22), .VDD(W21), .DVDD(W21));
  gf180mcu_fd_io__asig_5p0 W10 (.ASIG5V(W10), .VSS(W22), .DVSS(W22), .VDD(W21), .DVDD(W21));
  gf180mcu_fd_io__asig_5p0 W11 (.ASIG5V(W11), .VSS(W22), .DVSS(W22), .VDD(W21), .DVDD(W21));
  gf180mcu_fd_io__in_s W12 (.PU(W12_PU), .PD(W12_PD), .Y(W12_Y), .PAD(W12), .VSS(W22), .DVSS(W22), .VDD(W21), .DVDD(W21));
  gf180mcu_fd_io__in_c W13 (.PU(W13_PU), .PD(W13_PD), .Y(W13_Y), .PAD(W13), .VSS(W22), .DVSS(W22), .VDD(W21), .DVDD(W21));
  gf180mcu_fd_io__bi_24t W14 (.CS(W14_CS), .SL(W14_SL), .IE(W14_IE), .OE(W14_OE), .PU(W14_PU), .PD(W14_PD), .A(W14_A), .Y(W14_Y), .PAD(W14), .VSS(W22), .DVSS(W22), .VDD(W21), .DVDD(W21));
  gf180mcu_fd_io__bi_24t W15 (.CS(W15_CS), .SL(W15_SL), .IE(W15_IE), .OE(W15_OE), .PU(W15_PU), .PD(W15_PD), .A(W15_A), .Y(W15_Y), .PAD(W15), .VSS(W22), .DVSS(W22), .VDD(W21), .DVDD(W21));
  gf180mcu_fd_io__bi_24t W16 (.CS(W16_CS), .SL(W16_SL), .IE(W16_IE), .OE(W16_OE), .PU(W16_PU), .PD(W16_PD), .A(W16_A), .Y(W16_Y), .PAD(W16), .VSS(W22), .DVSS(W22), .VDD(W21), .DVDD(W21));
  gf180mcu_fd_io__bi_24t W17 (.CS(W17_CS), .SL(W17_SL), .IE(W17_IE), .OE(W17_OE), .PU(W17_PU), .PD(W17_PD), .A(W17_A), .Y(W17_Y), .PAD(W17), .VSS(W22), .DVSS(W22), .VDD(W21), .DVDD(W21));
  gf180mcu_fd_io__bi_24t W18 (.CS(W18_CS), .SL(W18_SL), .IE(W18_IE), .OE(W18_OE), .PU(W18_PU), .PD(W18_PD), .A(W18_A), .Y(W18_Y), .PAD(W18), .VSS(W22), .DVSS(W22), .VDD(W21), .DVDD(W21));
  gf180mcu_fd_io__bi_24t W19 (.CS(W19_CS), .SL(W19_SL), .IE(W19_IE), .OE(W19_OE), .PU(W19_PU), .PD(W19_PD), .A(W19_A), .Y(W19_Y), .PAD(W19), .VSS(W22), .DVSS(W22), .VDD(W21), .DVDD(W21));
  gf180mcu_fd_io__bi_24t W20 (.CS(W20_CS), .SL(W20_SL), .IE(W20_IE), .OE(W20_OE), .PU(W20_PU), .PD(W20_PD), .A(W20_A), .Y(W20_Y), .PAD(W20), .VSS(W22), .DVSS(W22), .VDD(W21), .DVDD(W21));
  gf180mcu_fd_io__dvdd W21 (.DVDD(W21), .VSS(W22), .DVSS(W22));
  gf180mcu_fd_io__dvss W22 (.DVSS(W22), .VDD(W21), .DVDD(W21));
  gf180mcu_fd_io__asig_5p0 E01 (.ASIG5V(E01), .VSS(W22), .DVSS(W22), .VDD(W21), .DVDD(W21));
  gf180mcu_fd_io__asig_5p0 E02 (.ASIG5V(E02), .VSS(W22), .DVSS(W22), .VDD(W21), .DVDD(W21));
  gf180mcu_fd_io__asig_5p0 E03 (.ASIG5V(E03), .VSS(W22), .DVSS(W22), .VDD(W21), .DVDD(W21));
  gf180mcu_fd_io__asig_5p0 E04 (.ASIG5V(E04), .VSS(W22), .DVSS(W22), .VDD(W21), .DVDD(W21));
  gf180mcu_fd_io__asig_5p0 E05 (.ASIG5V(E05), .VSS(W22), .DVSS(W22), .VDD(W21), .DVDD(W21));
  gf180mcu_fd_io__asig_5p0 E06 (.ASIG5V(E06), .VSS(W22), .DVSS(W22), .VDD(W21), .DVDD(W21));
  gf180mcu_fd_io__asig_5p0 E07 (.ASIG5V(E07), .VSS(W22), .DVSS(W22), .VDD(W21), .DVDD(W21));
  gf180mcu_fd_io__asig_5p0 E08 (.ASIG5V(E08), .VSS(W22), .DVSS(W22), .VDD(W21), .DVDD(W21));
  gf180mcu_fd_io__asig_5p0 E09 (.ASIG5V(E09), .VSS(W22), .DVSS(W22), .VDD(W21), .DVDD(W21));
  gf180mcu_fd_io__asig_5p0 E10 (.ASIG5V(E10), .VSS(W22), .DVSS(W22), .VDD(W21), .DVDD(W21));
  gf180mcu_fd_io__asig_5p0 E11 (.ASIG5V(E11), .VSS(W22), .DVSS(W22), .VDD(W21), .DVDD(W21));
  gf180mcu_fd_io__asig_5p0 E12 (.ASIG5V(E12), .VSS(W22), .DVSS(W22), .VDD(W21), .DVDD(W21));
  gf180mcu_fd_io__asig_5p0 E13 (.ASIG5V(E13), .VSS(W22), .DVSS(W22), .VDD(W21), .DVDD(W21));
  gf180mcu_fd_io__asig_5p0 E14 (.ASIG5V(E14), .VSS(W22), .DVSS(W22), .VDD(W21), .DVDD(W21));
  gf180mcu_fd_io__asig_5p0 E15 (.ASIG5V(E15), .VSS(W22), .DVSS(W22), .VDD(W21), .DVDD(W21));
  gf180mcu_fd_io__asig_5p0 E16 (.ASIG5V(E16), .VSS(W22), .DVSS(W22), .VDD(W21), .DVDD(W21));
  gf180mcu_fd_io__asig_5p0 E17 (.ASIG5V(E17), .VSS(W22), .DVSS(W22), .VDD(W21), .DVDD(W21));
  gf180mcu_fd_io__asig_5p0 E18 (.ASIG5V(E18), .VSS(W22), .DVSS(W22), .VDD(W21), .DVDD(W21));
  gf180mcu_fd_io__asig_5p0 E19 (.ASIG5V(E19), .VSS(W22), .DVSS(W22), .VDD(W21), .DVDD(W21));
  gf180mcu_fd_io__asig_5p0 E20 (.ASIG5V(E20), .VSS(W22), .DVSS(W22), .VDD(W21), .DVDD(W21));
  gf180mcu_fd_io__asig_5p0 E21 (.ASIG5V(E21), .VSS(W22), .DVSS(W22), .VDD(W21), .DVDD(W21));
  gf180mcu_fd_io__asig_5p0 E22 (.ASIG5V(E22), .VSS(W22), .DVSS(W22), .VDD(W21), .DVDD(W21));
  gf180mcu_fd_io__cor CORNER_4 (.VSS(W22), .DVSS(W22), .VDD(W21), .DVDD(W21));
  gf180mcu_fd_io__cor CORNER_3 (.VSS(W22), .DVSS(W22), .VDD(W21), .DVDD(W21));
  gf180mcu_fd_io__cor CORNER_2 (.VSS(W22), .DVSS(W22), .VDD(W21), .DVDD(W21));
  gf180mcu_fd_io__cor CORNER_1 (.VSS(W22), .DVSS(W22), .VDD(W21), .DVDD(W21));
  gf180mcu_fd_io__fill5 FILL_N00_1 (.VSS(W22), .DVSS(W22), .VDD(W21), .DVDD(W21));
  gf180mcu_fd_io__fill5 FILL_N00_2 (.VSS(W22), .DVSS(W22), .VDD(W21), .DVDD(W21));
  gf180mcu_fd_io__fill5 FILL_N00_3 (.VSS(W22), .DVSS(W22), .VDD(W21), .DVDD(W21));
  gf180mcu_fd_io__fill5 FILL_N00_4 (.VSS(W22), .DVSS(W22), .VDD(W21), .DVDD(W21));
  gf180mcu_fd_io__fill5 FILL_N00_5 (.VSS(W22), .DVSS(W22), .VDD(W21), .DVDD(W21));
  gf180mcu_fd_io__fill5 FILL_N01_1 (.VSS(W22), .DVSS(W22), .VDD(W21), .DVDD(W21));
  gf180mcu_fd_io__fill5 FILL_N01_2 (.VSS(W22), .DVSS(W22), .VDD(W21), .DVDD(W21));
  gf180mcu_fd_io__fill5 FILL_N01_3 (.VSS(W22), .DVSS(W22), .VDD(W21), .DVDD(W21));
  gf180mcu_fd_io__fill5 FILL_N01_4 (.VSS(W22), .DVSS(W22), .VDD(W21), .DVDD(W21));
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
  gf180mcu_fd_io__fill5 FILL_E22_3 (.VSS(W22), .DVSS(W22), .VDD(W21), .DVDD(W21));
  gf180mcu_fd_io__fill5 FILL_E22_4 (.VSS(W22), .DVSS(W22), .VDD(W21), .DVDD(W21));
  gf180mcu_fd_io__fill5 FILL_E22_5 (.VSS(W22), .DVSS(W22), .VDD(W21), .DVDD(W21));
endmodule
