mpa216/Deep-Learning-Accelerator-DLA-Engine-From-CNN-to-GenAI-SNN/3V3lib/gf180mcu_as_sc_mcu7t3v3-main/pdk/libs.ref/gf180mcu_as_sc_mcu7t3v3/verilog/gf180mcu_as_sc_mcu7t3v3.v

module gf180mcu_as_sc_mcu7t3v3__dlxfp_2(
	input VPW,
	input VNW,
	input VDD,
	input VSS,
	
	input ENA,
	input D,
	output Q
);

reg state;
always @(posedge ENA) state <= D;
assign Q = ENA ? !D : !state;

endmodule

module gf180mcu_as_sc_mcu7t3v3__dlxfn_2(
	input VPW,
	input VNW,
	input VDD,
	input VSS,
	
	input ENA,
	input D,
	output Q
);

reg state;
always @(negedge ENA) state <= D;
assign Q = ENA ? !state : !D;

endmodule

module gf180mcu_as_sc_mcu7t3v3__dlxtp_2(
	input VPW,
	input VNW,
	input VDD,
	input VSS,
	
	input ENA,
	input D,
	output Q
);

reg state;
always @(posedge ENA) state <= D;
assign Q = ENA ? D : state;

endmodule

module gf180mcu_as_sc_mcu7t3v3__dlxtn_2(
	input VPW,
	input VNW,
	input VDD,
	input VSS,
	
	input ENA,
	input D,
	output Q
);

reg state;
always @(negedge ENA) state <= D;
assign Q = ENA ? state : D;

endmodule

module gf180mcu_as_sc_mcu7t3v3__dfxtp_2(
	input VPW,
	input VNW,
	input VDD,
	input VSS,
	
	input CLK,
	input D,
	output Q
);

reg state;
always @(posedge CLK) state <= D;
assign Q = state;

endmodule

module gf180mcu_as_sc_mcu7t3v3__dfxtp_4(
	input VPW,
	input VNW,
	input VDD,
	input VSS,
	
	input CLK,
	input D,
	output Q
);

reg state;
always @(posedge CLK) state <= D;
assign Q = state;

endmodule

module gf180mcu_as_sc_mcu7t3v3__dfxtn_2(
	input VPW,
	input VNW,
	input VDD,
	input VSS,
	
	input CLK,
	input D,
	output Q
);

reg state;
always @(negedge CLK) state <= D;
assign Q = state;

endmodule

module gf180mcu_as_sc_mcu7t3v3__dfsrtp_2(
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

module gf180mcu_as_sc_mcu7t3v3__fill_2(
	input VPW,
	input VNW,
	input VDD,
	input VSS
);

endmodule

module gf180mcu_as_sc_mcu7t3v3__fill_4(
	input VPW,
	input VNW,
	input VDD,
	input VSS
);

endmodule

module gf180mcu_as_sc_mcu7t3v3__fill_8(
	input VPW,
	input VNW,
	input VDD,
	input VSS
);

endmodule

module gf180mcu_as_sc_mcu7t3v3__fillcap_4(
	input VPW,
	input VNW,
	input VDD,
	input VSS
);

endmodule

module gf180mcu_as_sc_mcu7t3v3__fillcap_8(
	input VPW,
	input VNW,
	input VDD,
	input VSS
);

endmodule

module gf180mcu_as_sc_mcu7t3v3__fillcap_16(
	input VPW,
	input VNW,
	input VDD,
	input VSS
);

endmodule

module gf180mcu_as_sc_mcu7t3v3__tieh_4(
	input VPW,
	input VNW,
	input VDD,
	input VSS,

	output ONE
);

assign ONE = 1'b1;

endmodule

module gf180mcu_as_sc_mcu7t3v3__tiel_4(
	input VPW,
	input VNW,
	input VDD,
	input VSS,

	output ZERO
);

assign ZERO = 1'b0;

endmodule

module gf180mcu_as_sc_mcu7t3v3__diode_2(
	input VPW,
	input VNW,
	input VDD,
	input VSS,

	input DIODE
);

endmodule

module gf180mcu_as_sc_mcu7t3v3__hcf_7(
	input VPW,
	input VNW,
	input VDD,
	input VSS,

	input HCF
);

endmodule
