mpa216/Deep-Learning-Accelerator-DLA-Engine-From-CNN-to-GenAI-SNN/3V3lib/gf180mcu_ocd_io-main/cells/bi_a/gf180mcu_ocd_io__bi_a.v

/*
 * Copyright 2022 GlobalFoundries PDK Authors
 *
 * Licensed under the Apache License, Version 2.0 (the "License");
 * you may not use this file except in compliance with the License.
 * You may obtain a copy of the License at
 *
 *     http:www.apache.org/licenses/LICENSE-2.0
 *
 * Unless required by applicable law or agreed to in writing, software
 * distributed under the License is distributed on an "AS IS" BASIS,
 * WITHOUT WARRANTIES OR CONDITIONS OF ANY KIND, either express or implied.
 * See the License for the specific language governing permissions and
 * limitations under the License.
 */

`suppress_faults
`enable_portfaults
`ifdef functional
  `timescale 1ns / 1ps
  `delay_mode_distributed
  `delay_mode_unit
`else
  `timescale 1ns / 1ps
  `delay_mode_path
`endif
module gf180mcu_ocd_io__bi_a (CS, SL, IE, OE, PU, PD, A, ANA, PDRV0, PDRV1, PAD, Y, DVDD, DVSS, VDD, VSS);
	input	CS;
	input	SL;
	input	IE;
	input	OE;
	input	PU;
	input	PD;
	input	A;
	inout	ANA;
	input	PDRV0;
	input	PDRV1;
	inout	PAD;
	output	Y;
	inout	DVDD;
	inout	DVSS;
	inout	VDD;
	inout	VSS;

	supply0 gnd;
	supply1 pwr;

   	and #1 (Y, PAD, IE);
   	bufif1 #1 (PAD, A, OE);

 	rnmos #1 (PAD, gnd, ~OE && ~PU && PD);
 	rnmos #1 (PAD, pwr, ~OE && PU && ~PD);

 	rnmos #1 (ANA, PAD, ~OE && ~IE);

specify
if (IE==1'b0&&OE==1'b1&&PDRV0==1'b0&&PDRV1==1'b0&&SL==1'b0) (A +=> PAD)=(1.000, 1.000);
if (IE==1'b0&&OE==1'b1&&PDRV0==1'b0&&PDRV1==1'b0&&SL==1'b1) (A +=> PAD)=(1.000, 1.000);
if (IE==1'b0&&OE==1'b1&&PDRV0==1'b0&&PDRV1==1'b1&&SL==1'b0) (A +=> PAD)=(1.000, 1.000);
if (IE==1'b0&&OE==1'b1&&PDRV0==1'b0&&PDRV1==1'b1&&SL==1'b1) (A +=> PAD)=(1.000, 1.000);
if (IE==1'b0&&OE==1'b1&&PDRV0==1'b1&&PDRV1==1'b0&&SL==1'b0) (A +=> PAD)=(1.000, 1.000);
if (IE==1'b0&&OE==1'b1&&PDRV0==1'b1&&PDRV1==1'b0&&SL==1'b1) (A +=> PAD)=(1.000, 1.000);
if (IE==1'b0&&OE==1'b1&&PDRV0==1'b1&&PDRV1==1'b1&&SL==1'b0) (A +=> PAD)=(1.000, 1.000);
if (IE==1'b0&&OE==1'b1&&PDRV0==1'b1&&PDRV1==1'b1&&SL==1'b1) (A +=> PAD)=(1.000, 1.000);
if (A==1'b1&&IE==1'b0&&PDRV0==1'b0&&PDRV1==1'b0&&SL==1'b0) (OE => PAD)=(1.000, 1.000, 1.000, 1.000, 1.000, 1.000);
if (A==1'b1&&IE==1'b0&&PDRV0==1'b0&&PDRV1==1'b0&&SL==1'b1) (OE => PAD)=(1.000, 1.000, 1.000, 1.000, 1.000, 1.000);
if (A==1'b1&&IE==1'b0&&PDRV0==1'b0&&PDRV1==1'b1&&SL==1'b0) (OE => PAD)=(1.000, 1.000, 1.000, 1.000, 1.000, 1.000);
if (A==1'b1&&IE==1'b0&&PDRV0==1'b0&&PDRV1==1'b1&&SL==1'b1) (OE => PAD)=(1.000, 1.000, 1.000, 1.000, 1.000, 1.000);
if (A==1'b1&&IE==1'b0&&PDRV0==1'b1&&PDRV1==1'b0&&SL==1'b0) (OE => PAD)=(1.000, 1.000, 1.000, 1.000, 1.000, 1.000);
if (A==1'b1&&IE==1'b0&&PDRV0==1'b1&&PDRV1==1'b0&&SL==1'b1) (OE => PAD)=(1.000, 1.000, 1.000, 1.000, 1.000, 1.000);
if (A==1'b1&&IE==1'b0&&PDRV0==1'b1&&PDRV1==1'b1&&SL==1'b0) (OE => PAD)=(1.000, 1.000, 1.000, 1.000, 1.000, 1.000);
if (A==1'b1&&IE==1'b0&&PDRV0==1'b1&&PDRV1==1'b1&&SL==1'b1) (OE => PAD)=(1.000, 1.000, 1.000, 1.000, 1.000, 1.000);
if (A==1'b0&&IE==1'b0&&PDRV0==1'b0&&PDRV1==1'b0&&SL==1'b0) (OE => PAD)=(1.000, 1.000, 1.000, 1.000, 1.000, 1.000);
if (A==1'b0&&IE==1'b0&&PDRV0==1'b0&&PDRV1==1'b0&&SL==1'b1) (OE => PAD)=(1.000, 1.000, 1.000, 1.000, 1.000, 1.000);
if (A==1'b0&&IE==1'b0&&PDRV0==1'b0&&PDRV1==1'b1&&SL==1'b0) (OE => PAD)=(1.000, 1.000, 1.000, 1.000, 1.000, 1.000);
if (A==1'b0&&IE==1'b0&&PDRV0==1'b0&&PDRV1==1'b1&&SL==1'b1) (OE => PAD)=(1.000, 1.000, 1.000, 1.000, 1.000, 1.000);
if (A==1'b0&&IE==1'b0&&PDRV0==1'b1&&PDRV1==1'b0&&SL==1'b0) (OE => PAD)=(1.000, 1.000, 1.000, 1.000, 1.000, 1.000);
if (A==1'b0&&IE==1'b0&&PDRV0==1'b1&&PDRV1==1'b0&&SL==1'b1) (OE => PAD)=(1.000, 1.000, 1.000, 1.000, 1.000, 1.000);
if (A==1'b0&&IE==1'b0&&PDRV0==1'b1&&PDRV1==1'b1&&SL==1'b0) (OE => PAD)=(1.000, 1.000, 1.000, 1.000, 1.000, 1.000);
if (A==1'b0&&IE==1'b0&&PDRV0==1'b1&&PDRV1==1'b1&&SL==1'b1) (OE => PAD)=(1.000, 1.000, 1.000, 1.000, 1.000, 1.000);
if (CS==1'b0&&OE==1'b0&&PAD==1'b1) (IE +=> Y)=(1.000, 1.000);
if (CS==1'b1&&OE==1'b0&&PAD==1'b1) (IE +=> Y)=(1.000, 1.000);
if (CS==1'b0&&IE==1'b1&&OE==1'b0) (PAD +=> Y)=(1.000, 1.000);
if (CS==1'b1&&IE==1'b1&&OE==1'b0) (PAD +=> Y)=(1.000, 1.000);
endspecify
endmodule
