mpa216/Deep-Learning-Accelerator-DLA-Engine-From-CNN-to-GenAI-SNN/(commit log)

2026-06-28 Move DLA project to Pop OS
    [01_release.csv, 02_Cell_List.csv, 03_Cell_Dimensions.csv, 04_Digital_IO_Cell.csv, 05_Analogue_Signal_Cell.csv, 06_Support_Cell.csv, 07_Digital_IO_Cell.csv, 08_Analogue_Signal_Cell.csv]
2026-07-02 Add Stage 2 padring integration, K=256 re-synthesis, and 3.3V bring-up
    Widens dla_engine_top's K parameter to 256 to match the GAN's actual
    weight depth, adds the serial bridge + chip_core_dla for padring
    integration, migrates to the 3.3V AS std-cell library, and vendors
    open-pdks for the padring PDK build.
    [sky130.lyt]
2026-07-04 Stage 2 padring full flow signed off + post-layout GLS + bring-up fixes
    Post-layout verification (2026-07-03):
    - tb/dla_engine_top_gls_tb.sv: gate-level sim of the routed as3v3_k256_d63
    netlist vs d3004n4 goldens - PASS, bit-exact, all 4 rows
    - g300_pipeline_tb -DGLS: full 784-pixel MNIST digit through the routed
    netlist - PASS, bit-exact (GLS ifdefs in g300_pipeline_top.v / tb)
    - seed-4 INT8 assets regenerated; sim binaries rebuilt
    Stage 2 full flow (2026-07-03 -> 04), runs/full_flow, 83/83 stages:
    - Magic DRC 0, KLayout DRC 0, chip-level LVS 0 (71,668 devices),
    antenna 0/0, XOR 0, IR drop 0.34 mV
    - Timing after fixes: setup +21.67 ns / hold +0.329 ns worst @ 40 ns,
    0 violations ac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
    [dla_engine_top_gls_tb.sv, g300_pipeline_tb.sv, g300_pipeline_top.v, gf180_sram_1rw_256x8.v]
2026-07-04 Update chipathon collateral to signed-off state; add APSIPA 2026 paper
    - Chipaton_Issue.md, pin requirement, and progress tracker rewritten to the
    final two-stage sign-off (11-macro 3.3 V core + chip_top padring, serial
    bridge pin map, single-supply 3.3 V decision, bring-up plan)
    - New paper apic_a_apsipa2026.tex in APSIPA ASC 2026 format (6 pages):
    updated results (40 ns / 25 MHz, K=256, chip-level LVS/DRC/antenna clean),
    new chip-integration section, verification incl. post-layout GLS
    - Fresh KLayout renders of the signed-off GDSes (Stage1_GDS, Chip_GDS)
    [GAN_CHIP_Pin_Requirement.xlsx, GAN_CHIP_Progress_Tracker_1.xlsx]
2026-07-04 Update README to signed-off state: Stage 1 macro + Stage 2 padring chip, serial bridge, GLS verification
2026-08-02 Fold the C buffer's three byte planes into one 64-deep macro
    C holds N*N = 16 accumulators of 24 bits, which is 48 bytes. It was three
    256x8 macros used as byte planes sharing an address bus, so it spent 203,313
    um2 to store 48 bytes in 768 -- 6.25% occupancy, and nothing about the design
    will ever make C larger. Folding the planes onto the address axis instead,
    addr = word*3 + plane, needs 48 of 64 and costs 45,861 um2. 64 is the
    shallowest depth this SRAM family offers, so that is the floor.
    Yosys confirms 9 macros where there were 11: A and B are untouched at 4 each.
    They cannot be reduced -- the 4x4 array consumes 4 A bytes and 4 B bytes every
    compute cycle and these are 1RW 8-bit parts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
    [0_release.csv, 1_pins_desc.csv, 2_truth_table.csv, 3_Capacitance_loading.csv, 4_Power_Consumption1.csv, 4_Power_Consumption2.csv, 4_Power_Consumption3.csv, 5_AC_Characteristics1.csv]
2026-08-02 Rearrange the nine macros into a 3x3 grid and shrink the die
    The C buffer collapsing to one macro left the old 4x3 grid with two empty
    slots, so this reflows the floorplan to 3x3 and takes the die down with it:
    1600x1500 -> 1400x1350, 2.40 -> 1.89 Mum2, -21%. Macro area is 745,485 ->
    588,029 um2.
    Rows keep the banks separated -- A across the bottom row and one slot of the
    middle, B across the top, C in the centre because it is the array's writeback
    target. Channels stay wide on purpose, ~124 um horizontally and ~169 um
    vertically. The 5V antenna study found every clustered floorplan was worse
    than the channel-fragmented grid, clustering alone taking antennas from 1 to
    4, so this squeezes th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
2026-08-02 Sweep density across the 3x3 die, and find the macro that is actually wrong
    Six runs from density 63 down to 51 on the squeezed 1400x1350 die. Every one
    signs off DRC 0, LVS 0, XOR 0 at 9 macros with setup between +15.66 and
    +16.44 ns, so the shrink itself is sound -- it is only antenna that resists.
    Density bottoms out in a basin at 54-56 holding a single ~1.1x net, and both
    directions away from it are worse: 2.18x at 63, four nets at 51. So the lever
    is spent at five runs, as expected.
    It did name the culprit though. u_b_buffer GEN_B_COLS[1] is the only macro that
    recurs -- 2.18x at density 63, then back at 1.49x and 1.18x at 51 -- and it
    sits in the top-left corner of the grid, the furt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
2026-08-02 Antenna-zero on the 9-macro die, by moving the one macro that kept failing
    c9_swapB1_d56 is the deliverable: antenna 0/0, Magic DRC 0, LVS 0, XOR 0, nine
    macros, setup +16.46 ns and hold +0.118 ns at the worst of nine corners at
    40 ns, 133 mW, on 1400x1350. config.yaml is promoted to it and reproduces it --
    c9_confirm_d56's final DEF is byte-identical at 21,620,402 B.
    Against the signed-off 11-macro chip that is 21% less die, 21% less SRAM, 12%
    fewer instances, 17% less power, and 1.34 ns more setup margin, with antenna
    still at zero.
    Density did not close it. Five runs from 63 down to 51 bottomed out in a basin
    at 54-56 holding one ~1.1x net, both directions worse. What they produced was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
2026-08-02 Shrink the die two sizes further, and find where it stops
    With the macro swap holding antenna-0, the die was pushed past the first win.
    Runs 11-14 keep the promoted swapped topology exactly -- B_COLS[1] centre, C
    corner -- and scale only DIE_AREA and the nine coordinates, so the channels
    tighten and nothing is re-rolled.
    c9_tiny1 at 1375x1325 is antenna 0/0, DRC 0, LVS 0, XOR 0, setup +16.24 ns and
    hold +0.116 ns, on 1,821,875 um2 with 79,676 instances. That is 24% less die
    than the signed-off 11-macro chip and, against the 1400x1350 winner, it costs
    0.22 ns of a 16 ns setup margin while saving 2,171 instances. Tightening pays
    twice here, the same way it has all sweep: the looser placement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
2026-08-03 Promote the 1375x1325 floorplan and confirm it reproduces
    config.yaml carried the 1400x1350 c9_swapB1_d56 geometry while c9_tiny1, found
    afterwards, was the better result. The two configs differed in exactly ten
    values -- DIE_AREA and the nine macro locations -- verified by diff before the
    copy; density stays 56 and the swapped topology is untouched.
    Re-run untouched as c9_tiny1_confirm, it reproduces c9_tiny1 exactly: the final
    DEF is byte-identical at 21,677,031 B and every key in final/metrics.json
    matches, zero differing entries rather than just the headline numbers. Antenna
    0/0, DRC/LVS/XOR 0, setup +16.236 / hold +0.1163 ns, 79,676 instances, 132.7 mW.
    c9_tiny1 is therefore the deliv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
2026-08-03 Update the gate-level testbench for the folded C buffer's read latency
    Folding C into one 64-deep macro moved every caller's read timing, and four
    testbenches were updated for it when the fold landed. dla_engine_top_gls_tb.sv
    was not: it still waited two edges, which is the old one-access contract, so
    running it against the hardened 9-macro netlist returned x on all four rows.
    The design was never at fault -- the four updated testbenches pass on the same
    RTL, including chip_core_dla_tb, which drives the identical C read path through
    the serial bridge at the pads.
    Fixed the same way the others were: hold rd_en and rd_addr steady across five
    edges. Five, not the four the RTL callers need, bec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
    [dla_engine_top_gls_tb.sv]
2026-08-03 Measure the numeric-format trade instead of asserting it
    Reviewers asked why INT8 rather than INT4, INT16 or FP16. quant_bitwidth_study.py
    answers it with numbers: it re-quantizes the FP32 generator checkpoint under this
    project's own per-tensor symmetric scheme, renders all ten sample latents, and
    scores each format against an exact FP64 render in gray levels of 255 -- the unit
    the output is actually judged in.
    Mean / max error over 7,840 pixels: INT4 22.26 / 255, INT8 1.22 / 72, INT16
    0.01 / 1, FP16 0.06 / 5. INT4 does not degrade the digit, it destroys it: a
    per-tensor scale leaves seven magnitude steps and the two 256-wide layers
    accumulate that coarseness over 256 terms. INT16 is essen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
2026-08-03 Add the paper for the nine-macro chip
    A second APSIPA paper, same format as the main-chip one, for the variant this
    branch builds: "An Area-Optimized 8-bit Deep Learning Accelerator for GAN Image
    Generation on GF180MCU". It is framed around what the branch actually
    contributes rather than the original paper with different numbers.
    The memory fold is the first result. C held 48 bytes in 768 across three 256x8
    byte-plane macros; folding the planes onto the address axis of one 64x8 macro
    cuts that buffer 77%, drops the macro count to nine, and lets the die reach
    1375x1325. That is 24% less die, 21% less SRAM area, 14% fewer instances and
    18% less power than the eleven-macro design, with better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
2026-08-06 Add chipathon dry-run submission for the nine-macro (tiny) chip
    info.yaml + lvs_config.json point the LVS flow at the signed-off nine-macro dla_engine_top macro (run c9_tiny1); add the referenced gds/dla_engine_top.gds and verilog/dla_engine_top.nl.v artifacts, and update the chipathon issue text to the nine-macro chip.
2026-08-06 Update README for the nine-macro (tiny) chip
    Reflect the area-optimized nine-macro design as the current lineage: folded C buffer (3x256x8 -> 1x64x8), nine SRAM macros, 1375x1325 um macro sign-off (setup +16.24 / hold +0.116 ns @ 40 ns, 9 corners), the read-the-net-names antenna closure, and the chipathon dry-run submission. Stage-2 chip_top is attributed to the eleven-macro predecessor (not re-run on the nine-macro macro).
2026-08-07 tiny2: clustered nine-macro squeeze to 1250x1250 (clust1250w), antenna-0 at -14% die
    Cluster the nine SRAM macros (channels 118/162 -> ~35 um) and shrink dla_engine_top from 1375x1325 to 1250x1250: -14.2% die area and -12.8% instances vs the signed-off c9_tiny1, holding antenna 0/0.
    clust1250 (~16 um channels) hardened clean but reopened 5 antenna nets, incl one structural 2.63x Metal3 cluster-crossing broadcast (net409). Widening the channels to ~35 um at the same die re-admits logic between the macros and cleared all five -> clust1250w: antenna 0/0, Magic DRC 0, LVS 0, XOR 0, route DRC 0, setup +16.01 / hold +0.121 ns (9 corners), 132.7 mW. Reproducible: clust1250w_confirm final DEF byte-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
2026-08-14 longtin: antenna-free 1600x1100 4x2 DLA (C as flip-flops) + UVM + review deck
    Place-and-route variant on branch longtin: rectangular 1600x1100 um die with the
    C result buffer as flip-flops (dla_engine_top USE_SRAM(0)), leaving 8 SRAM macros
    in a 4x2 grid. Antenna closed to 0/0 by clustering the macros centrally (55 um
    channels) plus a density sweep -> config_longtin_a3b_d50.yaml (density 50).
    Signoff: Magic DRC 0, routing DRC 0, GDS XOR 0, LVS match uniquely, setup
    +15.74 / hold +0.118 ns at 9 corners; confirmed reproducible (byte-identical DEF).
    config_longtin.yaml promoted to the d50 floorplan; roomy baseline kept as
    config_longtin_roomy.yaml and the a1/a3/a3b/a3b_d* sweep configs as the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
    [Chipathon 2026 Layout review rubric.xlsx]
2026-08-14 Promote longtin to the chipathon submission (eight-macro register-buffered DLA)
    Switch the submission from the nine-macro folded-C chip to the antenna-free
    eight-macro register-file design (run longtin_a3b_d50):
    - gds/dla_engine_top.gds + verilog/dla_engine_top.nl.v -> d50 outputs
    (8 sram256x8 macros, C buffer as flip-flops; the flow's Netgen LVS on this
    pair matched uniquely over 23,540 devices, 0 DRC/XOR/antenna)
    - lvs_config.json: drop the now-unused 64x8 SRAM spice
    - info.yaml: update the one-line description
    Also add the longtin conference paper (APIC_Paper_Longtin/) and refresh the
    layout-review deck with the d50 numbers, IR-drop, and pin requirements.
2026-08-14 Update the chipathon issue for the eight-macro longtin submission
    Reflect the promoted submission: eight SRAM macros with a flip-flop C result
    buffer, rectangular 1600x1100 um die (1.76 mm^2), antenna 0/0 closed 4->2->0,
    setup +15.74 / hold +0.118 ns, LVS 23,540 devices, ~121 mW. Verification claim
    softened to what was run on the flip-flop-C design (tile test + UVM); full-image
    and GLS re-simulation listed as remaining. Team, pin budget, and links unchanged.
2026-08-18 Add workshop-slot pin list to info.yaml; back longtin verification claims
    info.yaml: adopt the updated chipathon template's `pins:` block — the 11
    bonded pads of the shared workshop slot with their io_types (clk on in_s /
    input_schmitt, rst_n on in_c / input_cmos, the SCLK/MOSI/CS_N/MISO serial
    link and busy/done/wb_done status on bi_24t / bidirectional_24ma, single
    3.3 V DVDD/DVSS). The accelerator's 53-bit macro interface is wrapped behind
    the 4-wire serial bridge, so only these 9 signals + supplies leave the die.
    Verification: ran the full directed suite on the eight-macro flip-flop-C
    design (single-lane d3004, layer-row g3005, full-784px g300_pipeline,
    pad-level serial chip_core_dla)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
2026-08-18 Chipaton_Issue: mark verification complete (full suite + GLS pass)
    Full-image and gate-level re-simulation of the eight-macro netlist are no
    longer "remaining steps": the full directed suite (single-lane, tile,
    layer-row, full 784-px image, pad-level serial) and unit + full-image GLS
    on the longtin_a3b_d50 routed netlist all pass bit-exact, alongside the UVM
    env. Matches the paper's Verification section and info.yaml pin update (57fca5a).
2026-08-23 ACV block: bridge-wrapped dla_engine_chip + power-pin connector (DRC/LVS/XOR clean)
    Harden the accelerator (8 SRAM macros + 4-wire serial bridge) into the Chipathon 2026
    A56/ACV project block (1675x1110 um). The gf180 I/O cells hand power over as Metal2 pins
    in the die margin, but the PDN delivers it on a Metal4/M5 core ring inland, leaving
    DVDD/DVSS electrically islanded (chip LVS: 2 errors). connect_power_v3.py welds each
    template power pin to its own-net ring with short in-margin via stacks, each landing in a
    clean gap between the existing PDN vias (build_acv_connected.sh documents the reproducible
    flow). Welded as top-level PDN geometry -> self-contained GDS, no connect-by-label needed.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
    [A56_ACV_padring.v, dla_engine_chip.sv, dla_engine_chip_tb.sv]
2026-08-23 learning_notes: drop the LibreLane-flow-integration subsection (Part 9.8)
    The in-flow-connector future option is tracked in CLAUDE.md's ACV status block instead; Part 9 keeps the debugging story and final sign-off.
2026-08-25 ACV: re-harden dla_engine_chip on the new west-edge padframe + v4 power connector
    The auditor's 2026-08-24 A56_ACV.def moved DVSS from the north edge to the west
    (DVDD/DVSS now paired at W21/W22) and shifted every signal pin down one slot.
    Re-hardened against it (run acv_ring4) and rewrote the connector for both-west welds:
    - connect_power_v4.py: symmetric full-height Metal2 plates + tall via columns for
    BOTH DVDD and DVSS (90 via stacks, 1.875um clearance) -- supersedes v3's
    north-DVSS thin-strip/2-cut geometry; also the flagged current-robustness fix.
    - config_acv.yaml: GRT_ANTENNA_REPAIR_MARGIN 25 -> 75 (antenna 5 -> 3 -> 0 nets).
    - info.yaml: pin slots W12..W22 (was W13..W22 + N01).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
2026-08-25 Reorganize repo into topic folders + add auditor padframe collateral
    Move tracked papers -> Papers/, docs -> Documents/, and vendored references ->
    References_and_example/ (965 renames). Add the auditor's ACV padframe collateral
    under layout_announcement/ (old + new A56.def templates, pad maps, padring DEF/
    verilog/cfg, the GDS-audit xlsx, and the A36-A70 layout-review PDF).
    - .gitignore: exclude the 1.1 GB caravel-gf180mcu reference clone (kept locally,
    reference only), macOS junk (.DS_Store / ._*), LaTeX intermediates, *.tgz, and
    generalize the local-only GAN_CHIP_*.xlsx trackers.
    - Commit the long-pending removal of the obsolete stage2_padring/ tree (superseded
    by the per-project A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
    [A56_ACV_padring.cfg, Chipathon 2026 Layout review rubric.xlsx, Chipation 2026 project gds audit.xlsx, sky130.lyt]
2026-08-25 docs: refresh README/learning_notes for the ACV chip + SPEF-accurate signoff numbers
    - README.md: rewrite from the superseded nine-macro tiny chip to the current ACV
    dla_engine_chip (die 1675x1110, 8 macros + flip-flop C, serial bridge, power
    connector, per-project-block flow); Section VIII rewritten; file tree fixed
    (stage2_padring removed, Papers/, UVM). Timing/power set to SPEF-accurate 9-corner
    STA: setup +14.98 / hold +0.117 ns, ~125 mW, + a block IR-drop row.
    - learning_notes.md: add Part 11 -- a UVM explainer built around tb/uvm/dla_uvm.py.
    - config_acv.yaml: document the block IR-drop measurement (RUN_IRDROP_REPORT + resume
    --from OpenROAD.RCX on the connected design -> DVD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
2026-08-28 verify: full GAN image through the serial bridge on the taped-out netlist (gate-level 784/784)
    Close the deferred combined demo: the entire 64->256->256->784 generator driven
    end-to-end through the 4-wire serial bridge, on the signed-off gate netlist
    verilog/dla_engine_chip.nl.v -- bit-exact vs the Python golden (784/784 pixels).
    New:
    - tb/dla_engine_chip_gan_tb.sv -- ports g300_pipeline_top's tiling + host-side
    bias/requant/ReLU/Q20-tanh onto the serial-frame tasks (WRITE_A/WRITE_B/START/
    READ_C); accelerator reachable only over the pads. Passes at RTL and GLS.
    - tb/dla_engine_chip_wave_tb.sv -- short 1-tile gate-level capture for a
    renderable serial-protocol waveform (VCD).
    - script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
    [dla_engine_chip_gan_tb.sv, dla_engine_chip_wave_tb.sv]
2026-09-01 ACV: re-harden dla_engine_chip on the auditor NE-corner Metal2 keep-out (acv_ring6) + signoff reports
    The 2026-09-01 padframe revision adds a Metal2 keep-out in the NE die corner
    (1610-1675 x 1108-1110 um) against an integration short. The block already
    clears it (Metal2 tops at 1078.6 um, 29.4 um margin); re-hardened as acv_ring6
    with the keep-out enforced via ROUTING_OBSTRUCTIONS (added pre-route, stripped
    before streamout so it is never painted as metal). Sign-off reproduced clean:
    Magic DRC 0, Netgen LVS "match uniquely", XOR 0, antenna 0, SPEF 9-corner STA
    setup +14.98 / hold +0.117 ns.
    - gds/dla_engine_chip.gds swapped to acv_ring6 (netlist byte-identical)
    - signoff/A56/: curated DRC/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
    [A56_ACV_padring.cfg]
2026-09-18 Chip state: verification collateral, constraints, export-control answers, layout review
    Everything accumulated on top of the acv_ring6 close, none of it touching the
    signed-off flow:
    - constraints/: hand-written SDC for dla_engine_top and dla_engine_chip plus an
    OpenSTA validation script (the flow's own constraints were tool-generated).
    - formal/: SymbiYosys k-induction proofs for dla_controller and
    dla_serial_bridge (.sby + SVA property files, run_formal.sh; work dirs ignored).
    - rtl/dla_apb_slave.v + tb/dla_apb_tb.sv: APB3 register interface alternative to
    the 4-wire serial bridge, with its own directed testbench.
    - tb/dla_xprop_tb.sv: x-propagation / reset-domain checks.
    - tb/uvm/d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
    [Chipation 2026 project gds audit.xlsx]
2026-09-26 ACV: general power-pin connector, KLayout foundry DRC, new-format info.yaml
    - librelane/connect_power.py: edge/slot-agnostic replacement for connect_power_v3/v4.
    Reads pin edge + own-net RING from the ODB, spaces via stacks by their own
    footprint, keeps cut arrays >= 0.36 um from existing vias, checks >= 0.3 um to
    all foreign metal (incl. decoded signal wires), bridges under-served fingers of
    the same pad with a Metal2 spine, verifies every stack lands on its ring, and
    refuses to write on any failure. On acv_ring6 it reproduces v4 byte-for-byte
    minus one v4 stack whose Metal4 pad overhung the ring end. Verified: Magic DRC 0,
    XOR 0, Netgen LVS "match uniquely" on that output and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
2026-09-26 Add GF180 tapeout checklist, Week-37 slides, ACV sweep reports
    - gf180mcu_tapeout_checklist.md: organizers' GF180MCU open-PDK tapeout checklist
    - layout_announcement/Layout_presentation: Week-37 (2026-09-11) slide captures
    (pad spec: ground-first struck through; info.yaml ready flags; integration
    problems: DBU, via-array spacing, power connections, secondary ESD) and the
    original layout-review deck backup
    - librelane/sweep_reports/acv_ring{,2,3,4}: antenna/STA/metrics reports of the
    ACV re-hardens (run dirs are gitignored)
2026-09-27 learning_notes: fix stale and inaccurate statements (audit 2026-09-27)
    Audited all 17 Parts against the repo (files, runs, git history, sign-off
    reports); every change was checked against primary evidence.
    - Scope/intro, Parts 3-4 headings dated; tapeout top is dla_engine_chip.
    - Part 3: current west-edge pin map (clk on W12, the quadrant's first pad)
    alongside the superseded 2026-08-21 map; first-pin question noted.
    - Antenna history corrected (8 macros != antenna-free; longtin clustering +
    density 50; ACV via GRT_ANTENNA_REPAIR_MARGIN 25->75).
    - Step numbers (ApplyDEFTemplate = 27), the abandoned "reorder PDN" fix,
    the 2026-08-23 status note, 9-corner definition, PDN/core ring, 3.3 V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
